AA-CubeSat-Team/soci_pcb/README.md

# soci_pcb

## design_rules
Directory for the design rules of various PCB manufacturers.

## libraries
Directory for Eagle part/component libraries used across PCB designs.

## projects
Repository for PCBs designed for soci in EAGLE

Make sure to update your libraries, design rules, and projects paths by going to Options -> Directories in EAGLE.
