AA-CubeSat-Team/soci_pcb/design_rules/README.md

# Design Rules
Directory for design rules to comply with standards and/or manufacturing requirements for various PCB manufacturers
