AA-CubeSat-Team/soci_pcb/projects/README.md

# CIA_board
Direcotry for CIA board EAGLE files.

# COM_R_board
Direcotry for COM_R board EAGLE files.

# eps_flatsat_module
Directory for the EPS module EAGLE files being designed for use in flatsat testing.

# onboard_flight_computer
Directory for the onboard flight computer EAGLE files.

# real_time_clock_testboard
Directory for the test board for the RTC circuit. The RTC was tested on a breadboard, and this board was never fabricated.

# sensor_board
Directory for the EAGLE files for the sensors board.
