AA-CubeSat-Team/soci_pcb/design_rules/macrofab/README.md

# Design Rules
Directory for design rules to comply with standards and/or manufacturing requirements of MacroFab PCB manufacturing
