AA-CubeSat-Team/soci_pcb/projects/COM_R/README.md

Folder containing PCB files for COM_R board
