AA-CubeSat-Team/soci_pcb/projects/CIA_board/README

Folder containing EAGLE files for the CIA board
