AA-CubeSat-Team/soci_pcb/projects/onboard_flight_computer/old_versions/README.md

# Backup Files
Folder containing backup EAGLE files for the OBC board
