AA-CubeSat-Team/soci_pcb/projects/CIA_board/old_versions/README.md

# Backup Files
Folder containing backup EAGLE files for the CIA board
