AA-CubeSat-Team/soci_pcb/projects/manufactured_brds/README.md

## This folder Contains all of the Eagle files for boards that have been previously manufactured
