AA-CubeSat-Team/soci_pcb/projects/manufactured_brds/CIA_manufactured.brd

## EAGLE design projects/manufactured_brds/CIA_manufactured.brd (2021-11-19)

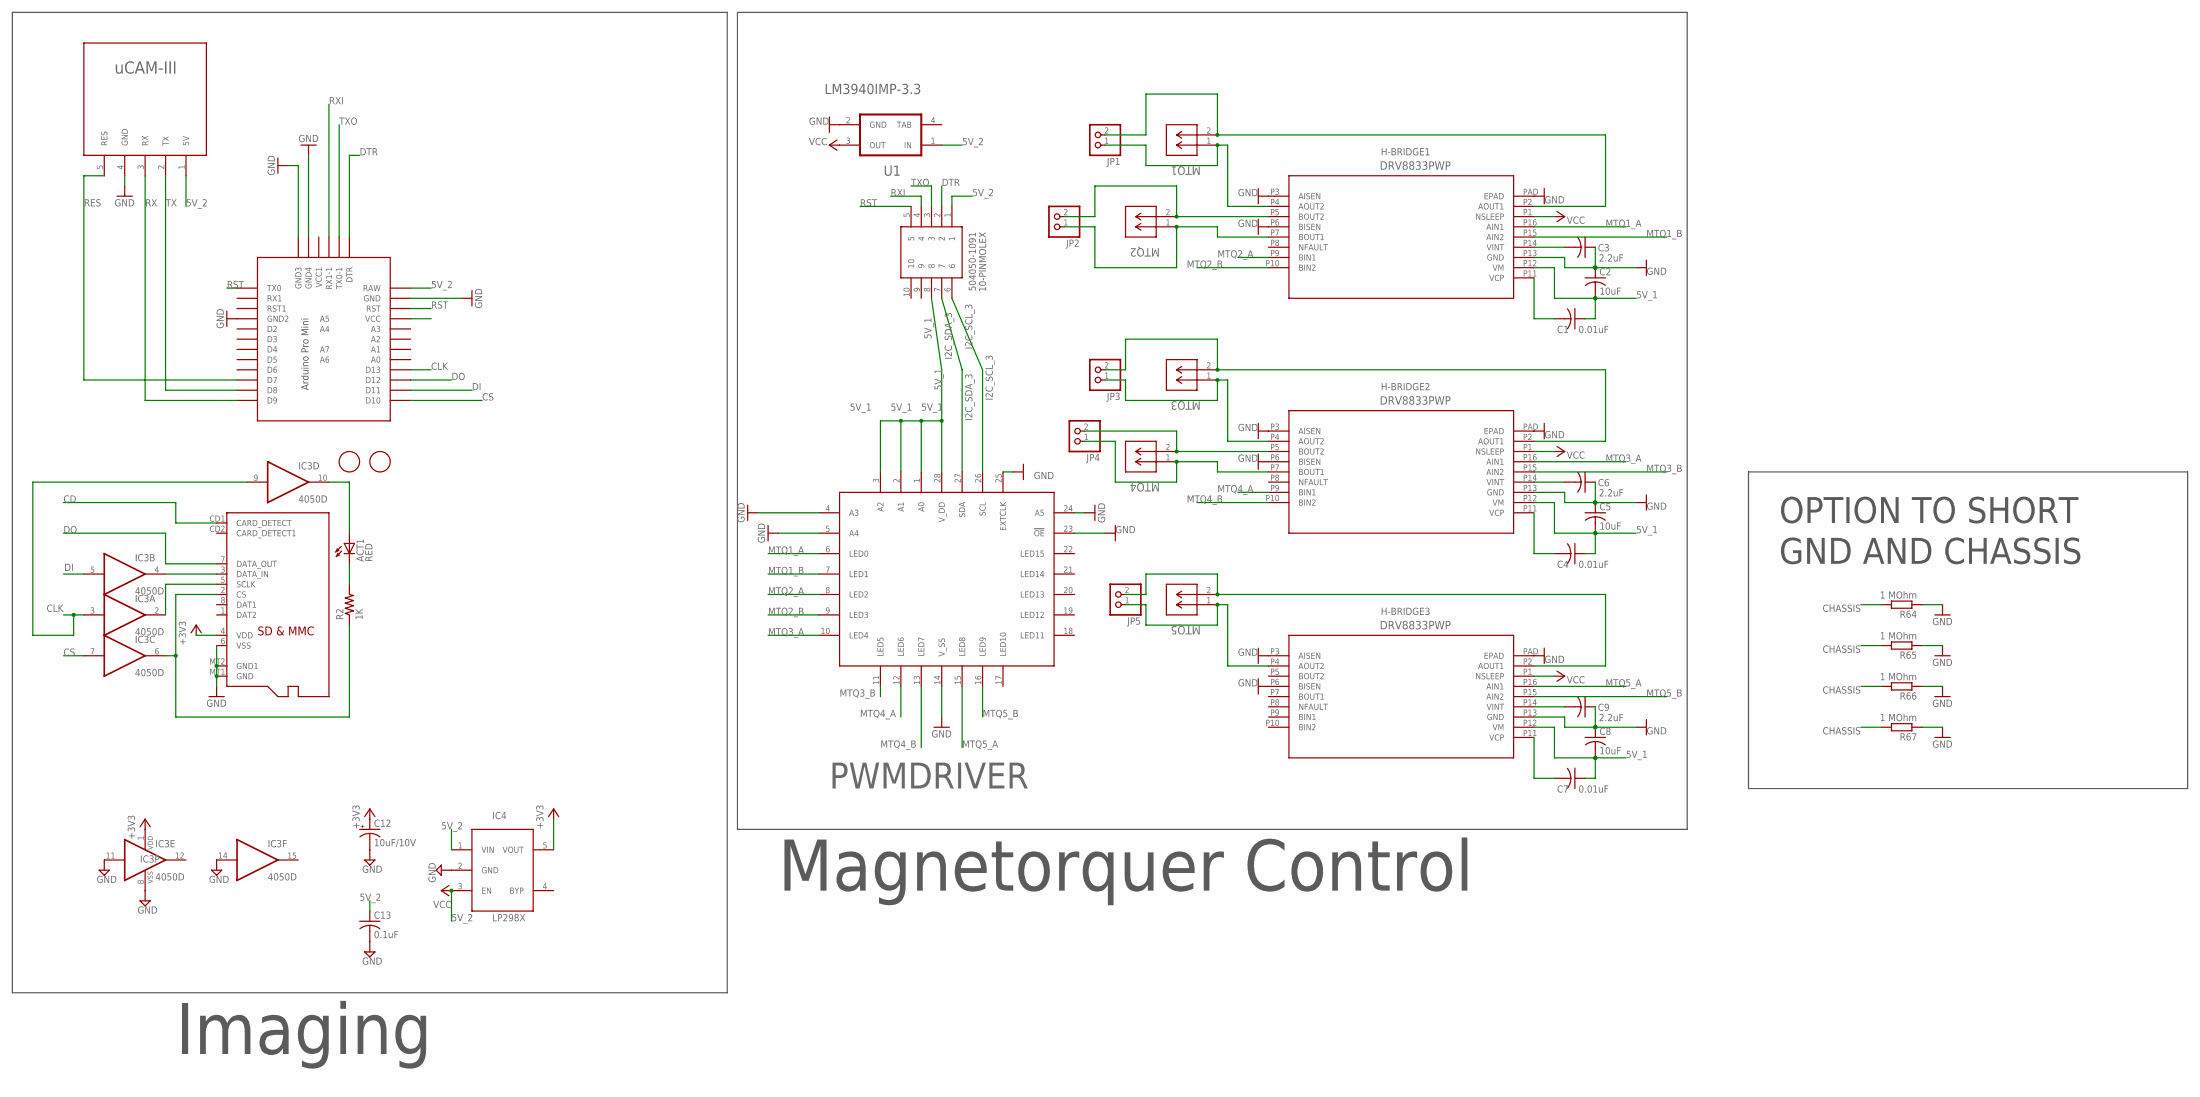
[picture p1: schematic CIA_manufactured.sch]

Parts:
10-PINMOLEX: 504050-1091
ACT1: RED; CHIP-LED0805
C1, C4, C7: 0.01uF; C0603K
C2, C5, C8: 10uF; C1210K
C3, C6, C9: 2.2uF; C0603K
C12: 10uF/10V; A/3216-18R
C13: 0.1uF; C0805K
H-BRIDGE1, H-BRIDGE2, H-BRIDGE3: DRV8833PWP; HTSSOP16
IC3: 4050D; SO16
IC4: LP298XS; SOT23-5L
JP1, JP2, JP3, JP4, JP5: PINHD-1X2; 1X02; MPN 22-11-2022
MTQ1, MTQ2, MTQ3, MTQ4, MTQ5: DF13C-2P-1.25V(51); CON2_1X2_U_DF13
PWMDRIVER: PCA9685PW; TSSOP28
R2: 1K; R0805
R64, R65, R66, R67: 1 MOhm; R0805
U1: TI_NATIONAL_SEMICONDUCTOR_LM3940IMP-3.3TI_NATIONA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; TI_NATIONAL_SEMICONDUCTOR_LM3940IMP-3.3_1
U$2: UCAM-III
U$6, U$7: FIDUCIAL; FIDUCIAL_1MM
U$8: PRO-MINI-2
X2: MICROSD

Connections:
5V_1: 10-PINMOLEX.8, C1.1, C2.2, C4.1, C5.2, C7.1, C8.2, H-BRIDGE1.P12 (VM), H-BRIDGE2.P12 (VM), H-BRIDGE3.P12 (VM), PWMDRIVER.1 (A0), PWMDRIVER.2 (A1), PWMDRIVER.3 (A2), PWMDRIVER.28 (V_DD)
5V_2: 10-PINMOLEX.1, C13.1, IC4.1 (VIN), IC4.3 (EN), U1.1 (IN), U$2.1 (5V), U$8.RAW
+3V3: C12.+, IC3.1 (VDD), IC4.5 (VOUT), X2.4 (VDD)
CD: X2.CD1 (CARD_DETECT)
CHASSIS: R64.2, R65.2, R66.2, R67.2
CLK: IC3.3 (I), IC3.9 (I), U$8.D13
CS: IC3.7 (I), U$8.D10
DI: IC3.5 (I), U$8.D11
DO: U$8.D12, X2.7 (DATA_OUT)
DTR: 10-PINMOLEX.2, U$8.DTR
GND: C2.1, C3.1, C5.1, C6.1, C8.1, C9.1, C12.-, C13.2, H-BRIDGE1.P3 (AISEN), H-BRIDGE1.P6 (BISEN), H-BRIDGE1.P13 (GND), H-BRIDGE1.PAD (EPAD), H-BRIDGE2.P3 (AISEN), H-BRIDGE2.P6 (BISEN), H-BRIDGE2.P13 (GND), H-BRIDGE2.PAD (EPAD), H-BRIDGE3.P3 (AISEN), H-BRIDGE3.P6 (BISEN), H-BRIDGE3.P13 (GND), H-BRIDGE3.PAD (EPAD), IC3.8 (VSS), IC3.11 (I), IC3.14 (I), IC4.2 (GND), PWMDRIVER.4 (A3), PWMDRIVER.5 (A4), PWMDRIVER.14 (V_SS), PWMDRIVER.23 (!OE), PWMDRIVER.24 (A5), PWMDRIVER.25 (EXTCLK), R64.1, R65.1, R66.1, R67.1, U1.2 (GND), U$8.GND, U$8.GND1 (GND2), U$8.GND2 (GND3), U$8.GND3 (GND4), X2.6 (VSS), X2.MT1 (GND), X2.MT2 (GND1)
I2C_SCL_3: 10-PINMOLEX.6, PWMDRIVER.26 (SCL)
I2C_SDA_3: 10-PINMOLEX.7, PWMDRIVER.27 (SDA)
MTQ1_A: H-BRIDGE1.P16 (AIN1), PWMDRIVER.6 (LED0)
MTQ1_B: H-BRIDGE1.P15 (AIN2), PWMDRIVER.7 (LED1)
MTQ2_A: H-BRIDGE1.P9 (BIN1), PWMDRIVER.8 (LED2)
MTQ2_B: H-BRIDGE1.P10 (BIN2), PWMDRIVER.9 (LED3)
MTQ3_A: H-BRIDGE2.P16 (AIN1), PWMDRIVER.10 (LED4)
MTQ3_B: H-BRIDGE2.P15 (AIN2), PWMDRIVER.11 (LED5)
MTQ4_A: H-BRIDGE2.P9 (BIN1), PWMDRIVER.12 (LED6)
MTQ4_B: H-BRIDGE2.P10 (BIN2), PWMDRIVER.13 (LED7)
MTQ5_A: H-BRIDGE3.P16 (AIN1), PWMDRIVER.15 (LED8)
MTQ5_B: H-BRIDGE3.P15 (AIN2), PWMDRIVER.16 (LED9)
unnamed: H-BRIDGE2.P2 (AOUT1), JP3.2, MTQ3.2
unnamed: C3.2, H-BRIDGE1.P14 (VINT)
unnamed: H-BRIDGE1.P4 (AOUT2), JP1.1, MTQ1.1
unnamed: H-BRIDGE1.P2 (AOUT1), JP1.2, MTQ1.2
unnamed: H-BRIDGE1.P7 (BOUT1), JP2.1, MTQ2.1
unnamed: H-BRIDGE1.P5 (BOUT2), JP2.2, MTQ2.2
unnamed: C1.2, H-BRIDGE1.P11 (VCP)
unnamed: H-BRIDGE2.P7 (BOUT1), JP4.1, MTQ4.1
unnamed: H-BRIDGE2.P5 (BOUT2), JP4.2, MTQ4.2
unnamed: C6.2, H-BRIDGE2.P14 (VINT)
unnamed: C4.2, H-BRIDGE2.P11 (VCP)
unnamed: H-BRIDGE2.P4 (AOUT2), JP3.1, MTQ3.1
unnamed: H-BRIDGE3.P2 (AOUT1), JP5.2, MTQ5.2
unnamed: C9.2, H-BRIDGE3.P14 (VINT)
unnamed: C7.2, H-BRIDGE3.P11 (VCP)
unnamed: H-BRIDGE3.P4 (AOUT2), JP5.1, MTQ5.1
unnamed: ACT1.A, IC3.10 (O)
unnamed: IC3.2 (O), X2.5 (SCLK)
unnamed: IC3.6 (O), R2.1, X2.2 (CS)
unnamed: ACT1.C, R2.2
unnamed: IC3.4 (O), X2.3 (DATA_IN)
RES: U$2.5 (RES), U$8.D7
RST: 10-PINMOLEX.5, U$8.RST
RX: U$2.3 (RX), U$8.D9
RXI: 10-PINMOLEX.4, U$8.RX1-1
TAB: U1.4 (TAB)
TX: U$2.2 (TX), U$8.D8
TXO: 10-PINMOLEX.3, U$8.TX0-1
VCC: H-BRIDGE1.P1 (NSLEEP), H-BRIDGE2.P1 (NSLEEP), H-BRIDGE3.P1 (NSLEEP), U1.3 (OUT)

Notes on the sheet:
Imaging
Magnetorquer Control
OPTION TO SHORT
GND AND CHASSIS

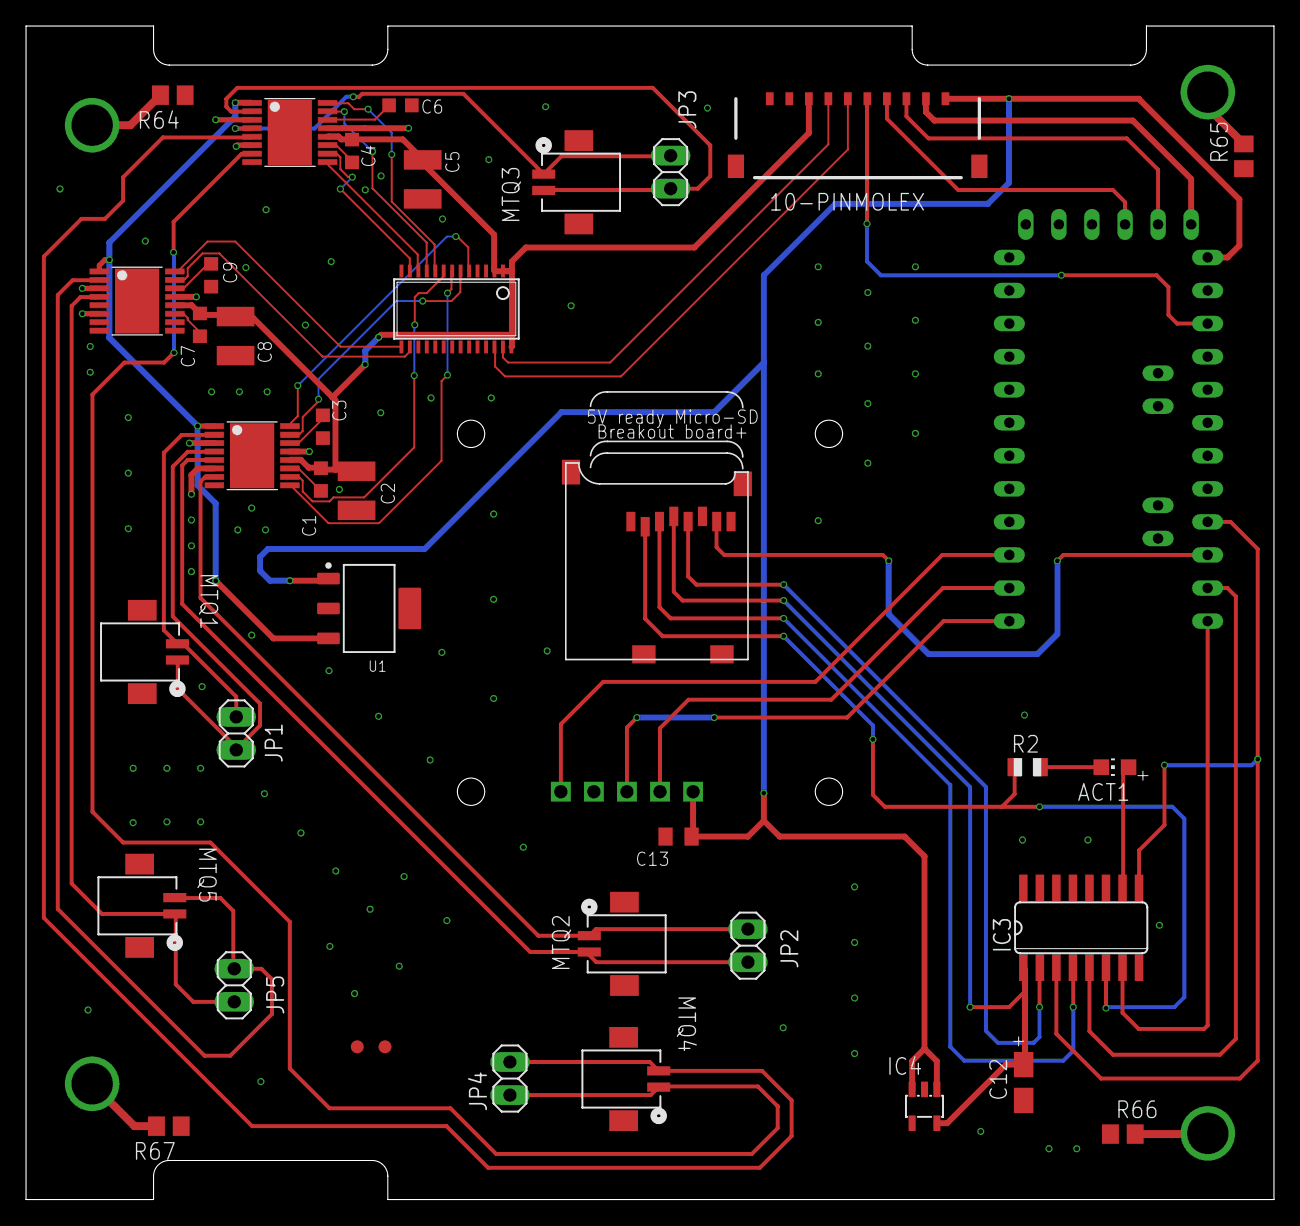
[picture p2: board CIA_manufactured.brd from above]

Board: 4 copper layers, 95.9 x 90.2 mm, 40 parts (0 on the bottom side), 50 nets.
