AA-CubeSat-Team/soci_pcb/projects/manufactured_brds/COM_R_manufactured.brd

## EAGLE design projects/manufactured_brds/COM_R_manufactured.brd (2021-11-19)

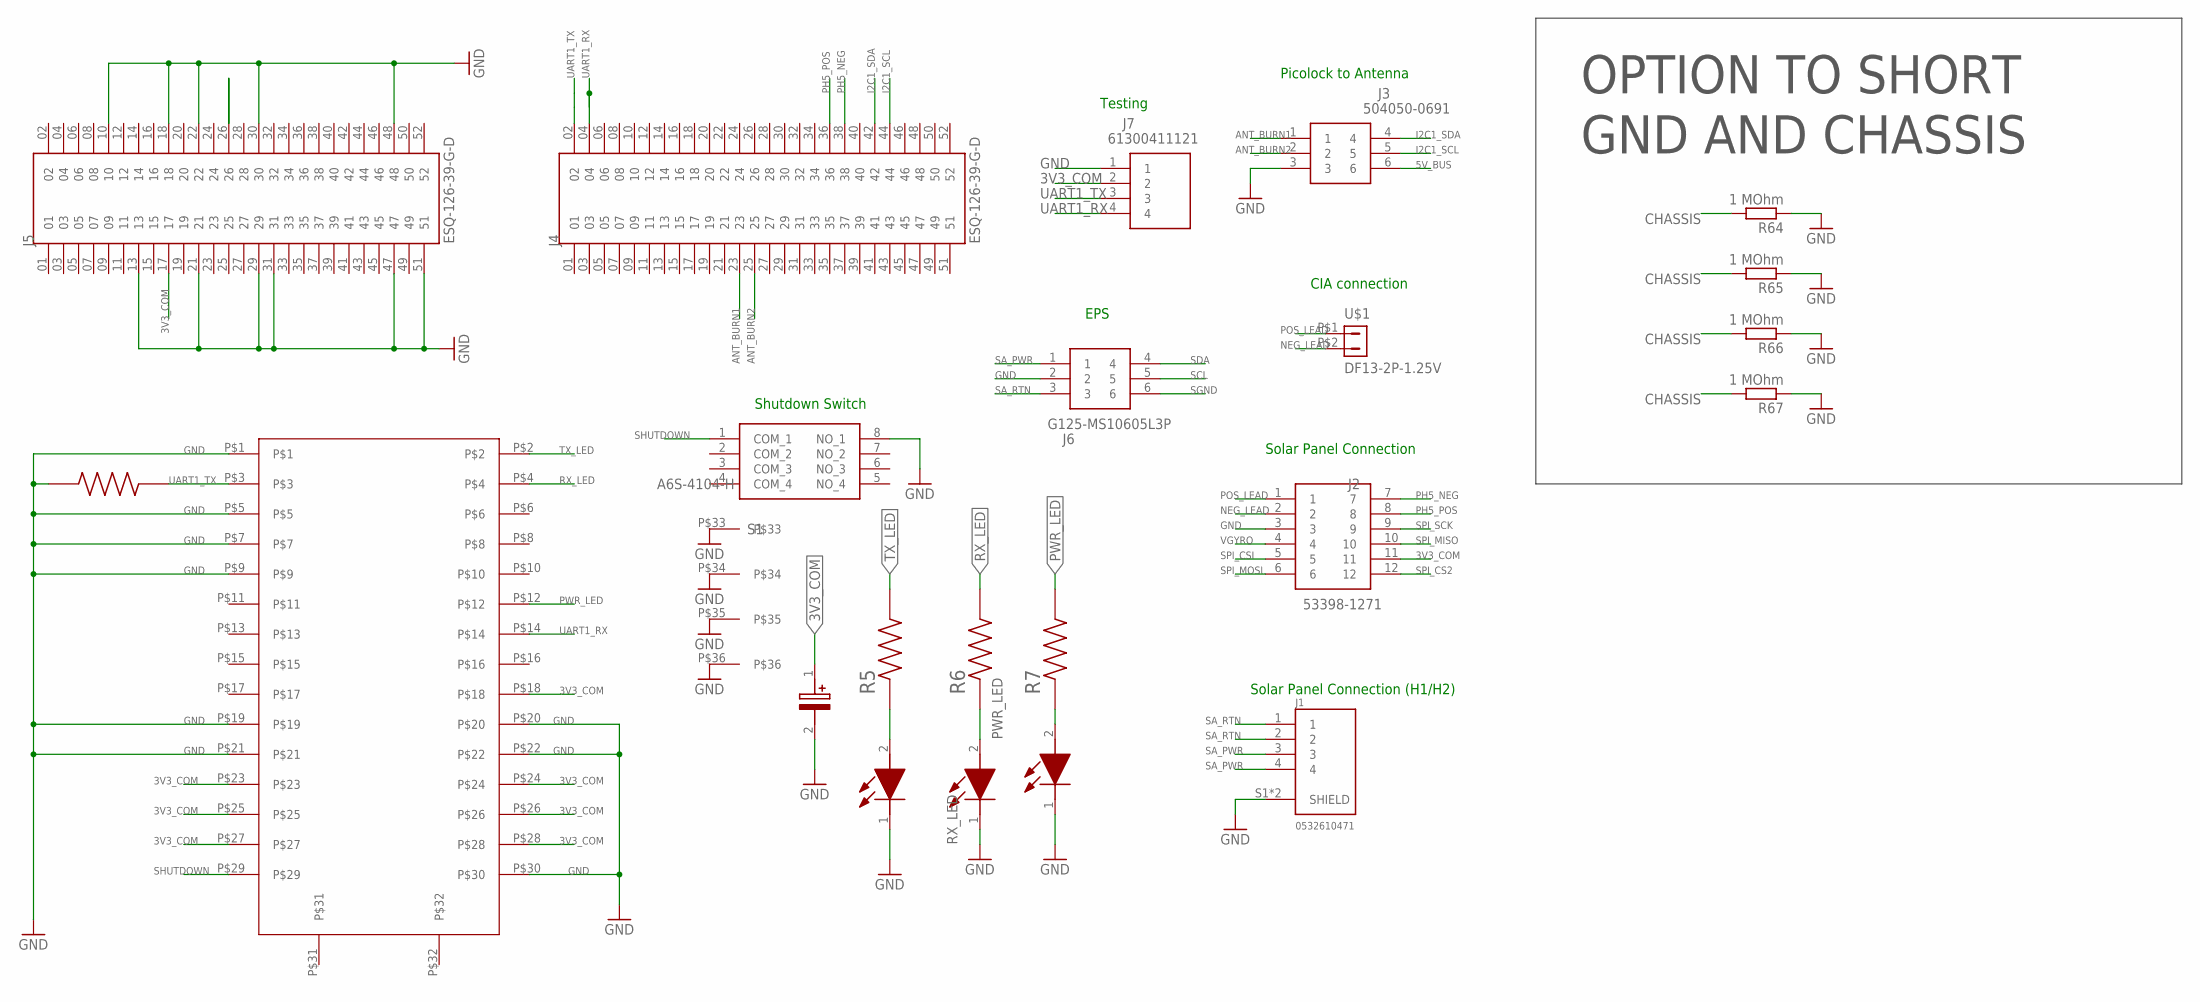
[picture p3: schematic COM_R_manufactured.sch]

Parts:
C2: 293D106X0010A2TE3; CAPPM3216X180N
J1: 0532610471; MOLEX_0532610471
J2: 53398-1271
J3: 504050-0691; 504050-0691_2
J4, J5: ESQ-126-39-G-D; SAMTEC_ESQ-126-39-G-D
J6: G125-MS10605L3P
J7: 61300411121; HDRV4W95P0X254_1X4_1016X254X85
PWR_LED: HSMQ-C170-T0000; LEDC2012X90N
R3: TNPW080510K0BETY; RESC2012X55N
R5, R6, R7: Y40621K00000Q0R; RESC2012X64N
R64, R65, R66, R67: 1 MOhm; R0805
RX_LED: HSMQ-C170-T0000; LEDC2012X90N
S1: A6S-4104-H; A6S4104H
TX_LED: HSMQ-C170-T0000; LEDC2012X90N
U$1: DF13-2P-1.25V; DF13C-2P-1.25V
U$3: XDLRADIOCONNECTORBREAKOUT_KYOCERA_5046_30PIN

Connections:
3V3_COM: C2.1 (+), J2.11, J5.17, J7.2, U$3.P$18, U$3.P$23, U$3.P$24, U$3.P$25, U$3.P$26, U$3.P$27, U$3.P$28
5V_BUS: J3.6, J5.26
ANT_BURN1: J3.1, J4.23
ANT_BURN2: J3.2, J4.25
CHASSIS: R64.2, R65.2, R66.2, R67.2
GND: C2.2 (-), J1.S1 (SHIELD), J1.S2 (SHIELD), J2.3, J3.3, J5.10, J5.13, J5.18, J5.21, J5.22, J5.29, J5.30, J5.31, J5.47, J5.48, J5.51, J6.2, J7.1, PWR_LED.1 (K), R3.1, R64.1, R65.1, R66.1, R67.1, RX_LED.1 (K), S1.8 (NO_1), TX_LED.1 (K), U$3.P$1, U$3.P$5, U$3.P$7, U$3.P$9, U$3.P$19, U$3.P$20, U$3.P$21, U$3.P$22, U$3.P$30, U$3.P$33, U$3.P$34, U$3.P$35, U$3.P$36
I2C1_SCL: J3.5, J4.44
I2C1_SDA: J3.4, J4.42
unnamed: R5.1, TX_LED.2 (A)
unnamed: PWR_LED.2 (A), R7.1
unnamed: R6.1, RX_LED.2 (A)
NEG_LEAD: J2.2, U$1.P$2 (2)
PH5_NEG: J2.7, J4.38
PH5_POS: J2.8, J4.36
POS_LEAD: J2.1, U$1.P$1 (1)
PWR_LED: R7.2, U$3.P$12
RX_LED: R6.2, U$3.P$4
SA_PWR: J1.3, J1.4, J6.1
SA_RTN: J1.1, J1.2, J6.3
SCL: J6.5
SDA: J6.4
SGND: J6.6
SHUTDOWN: S1.1 (COM_1), U$3.P$29
SPI_CS2: J2.12
SPI_CSI: J2.5
SPI_MISO: J2.10
SPI_MOSI: J2.6
SPI_SCK: J2.9
TX_LED: R5.2, U$3.P$2
UART1_RX: J4.04, J7.4, U$3.P$14
UART1_TX: J4.02, J7.3, R3.2, U$3.P$3
VGYRO: J2.4

Notes on the sheet:
Solar Panel Connection
Picolock to Antenna
Solar Panel Connection (H1/H2)
Shutdown Switch
CIA connection
EPS
Testing
OPTION TO SHORT
GND AND CHASSIS

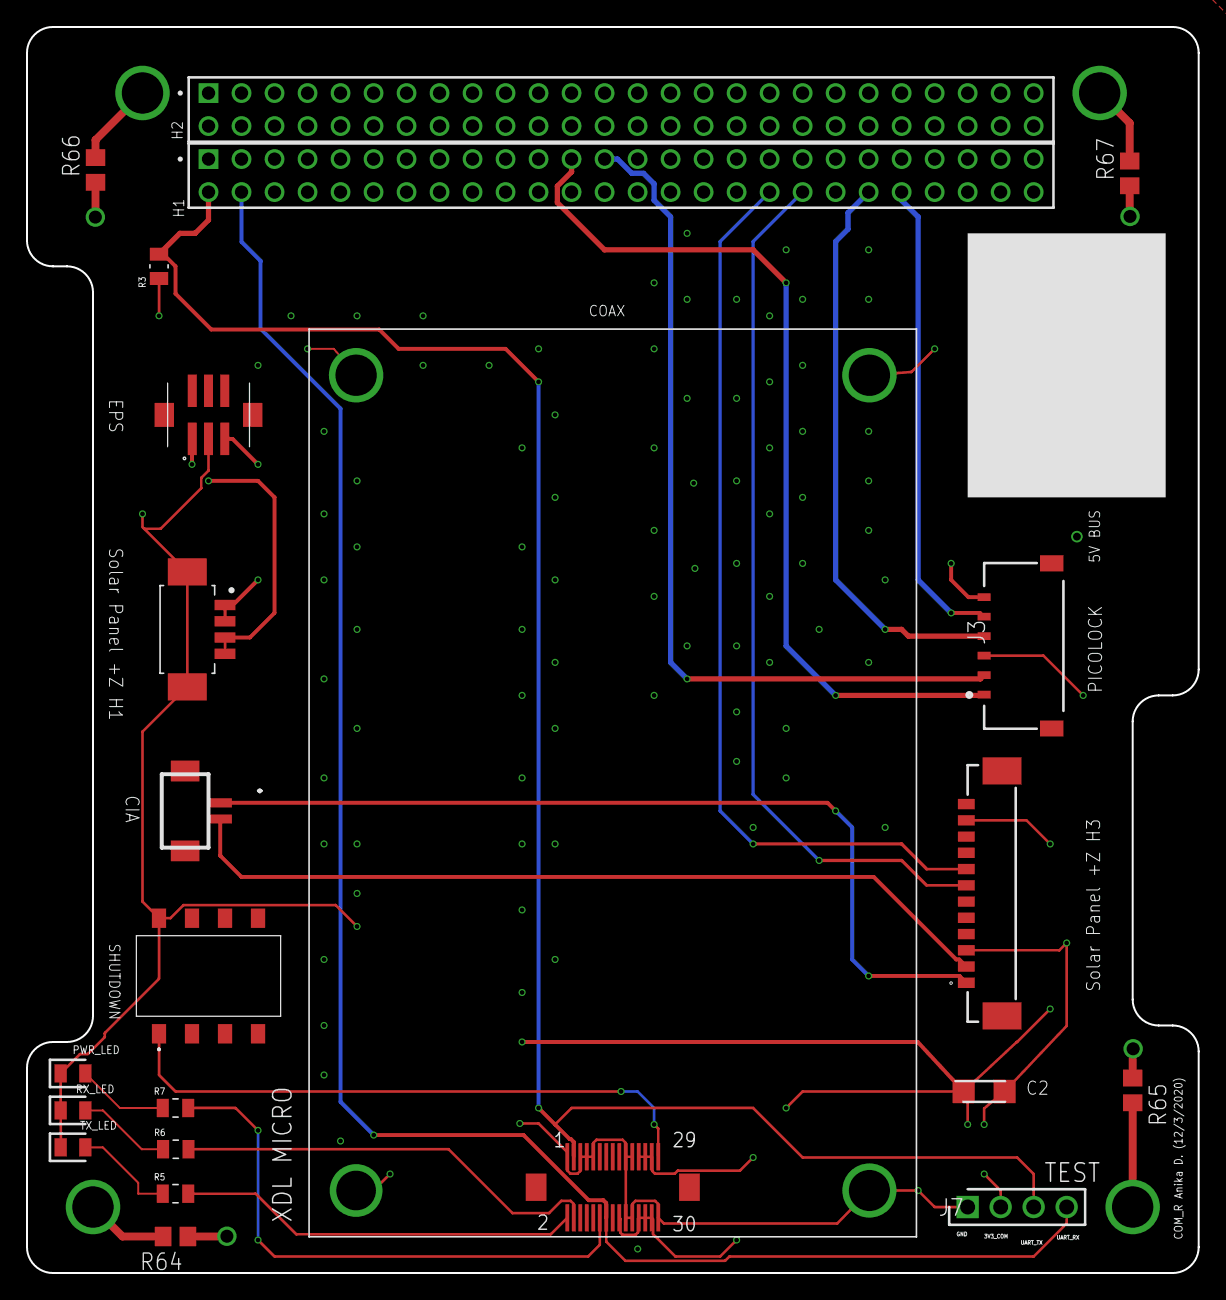
[picture p4: board COM_R_manufactured.brd from above]

Board: 4 copper layers, 90.2 x 95.9 mm, 22 parts (0 on the bottom side), 23 nets.
