AA-CubeSat-Team/soci_pcb/projects/manufactured_brds/OBC_manufactured.brd

## EAGLE design projects/manufactured_brds/OBC_manufactured.brd (2021-10-27)

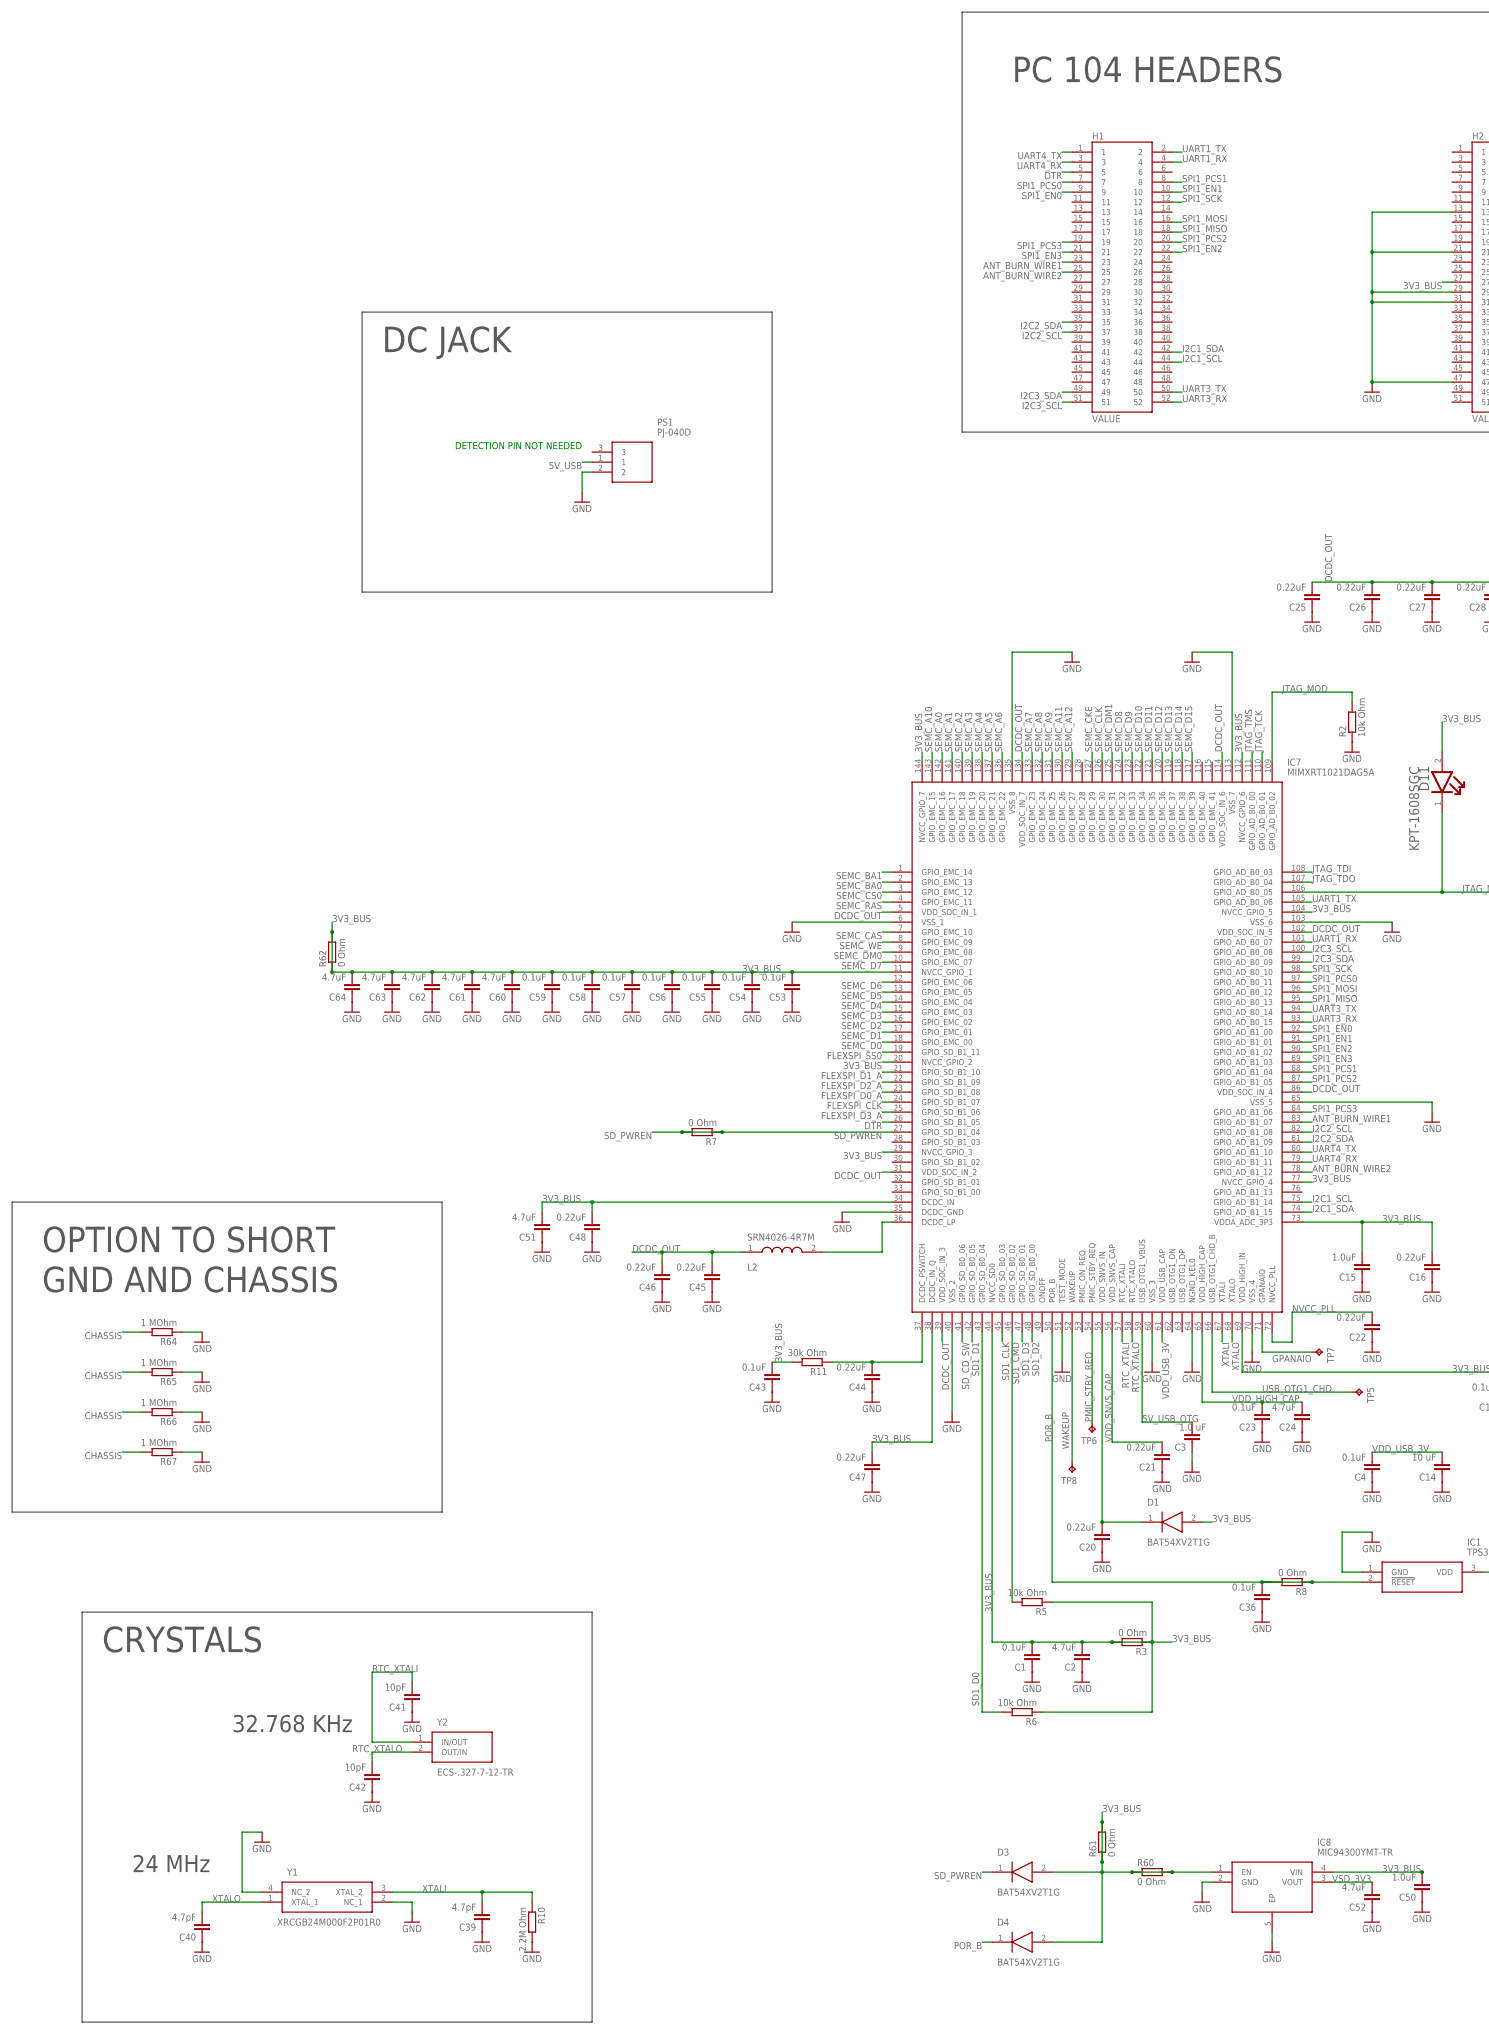
[picture p5: schematic OBC_manufactured.sch, MCU, part in row 1, column 1]

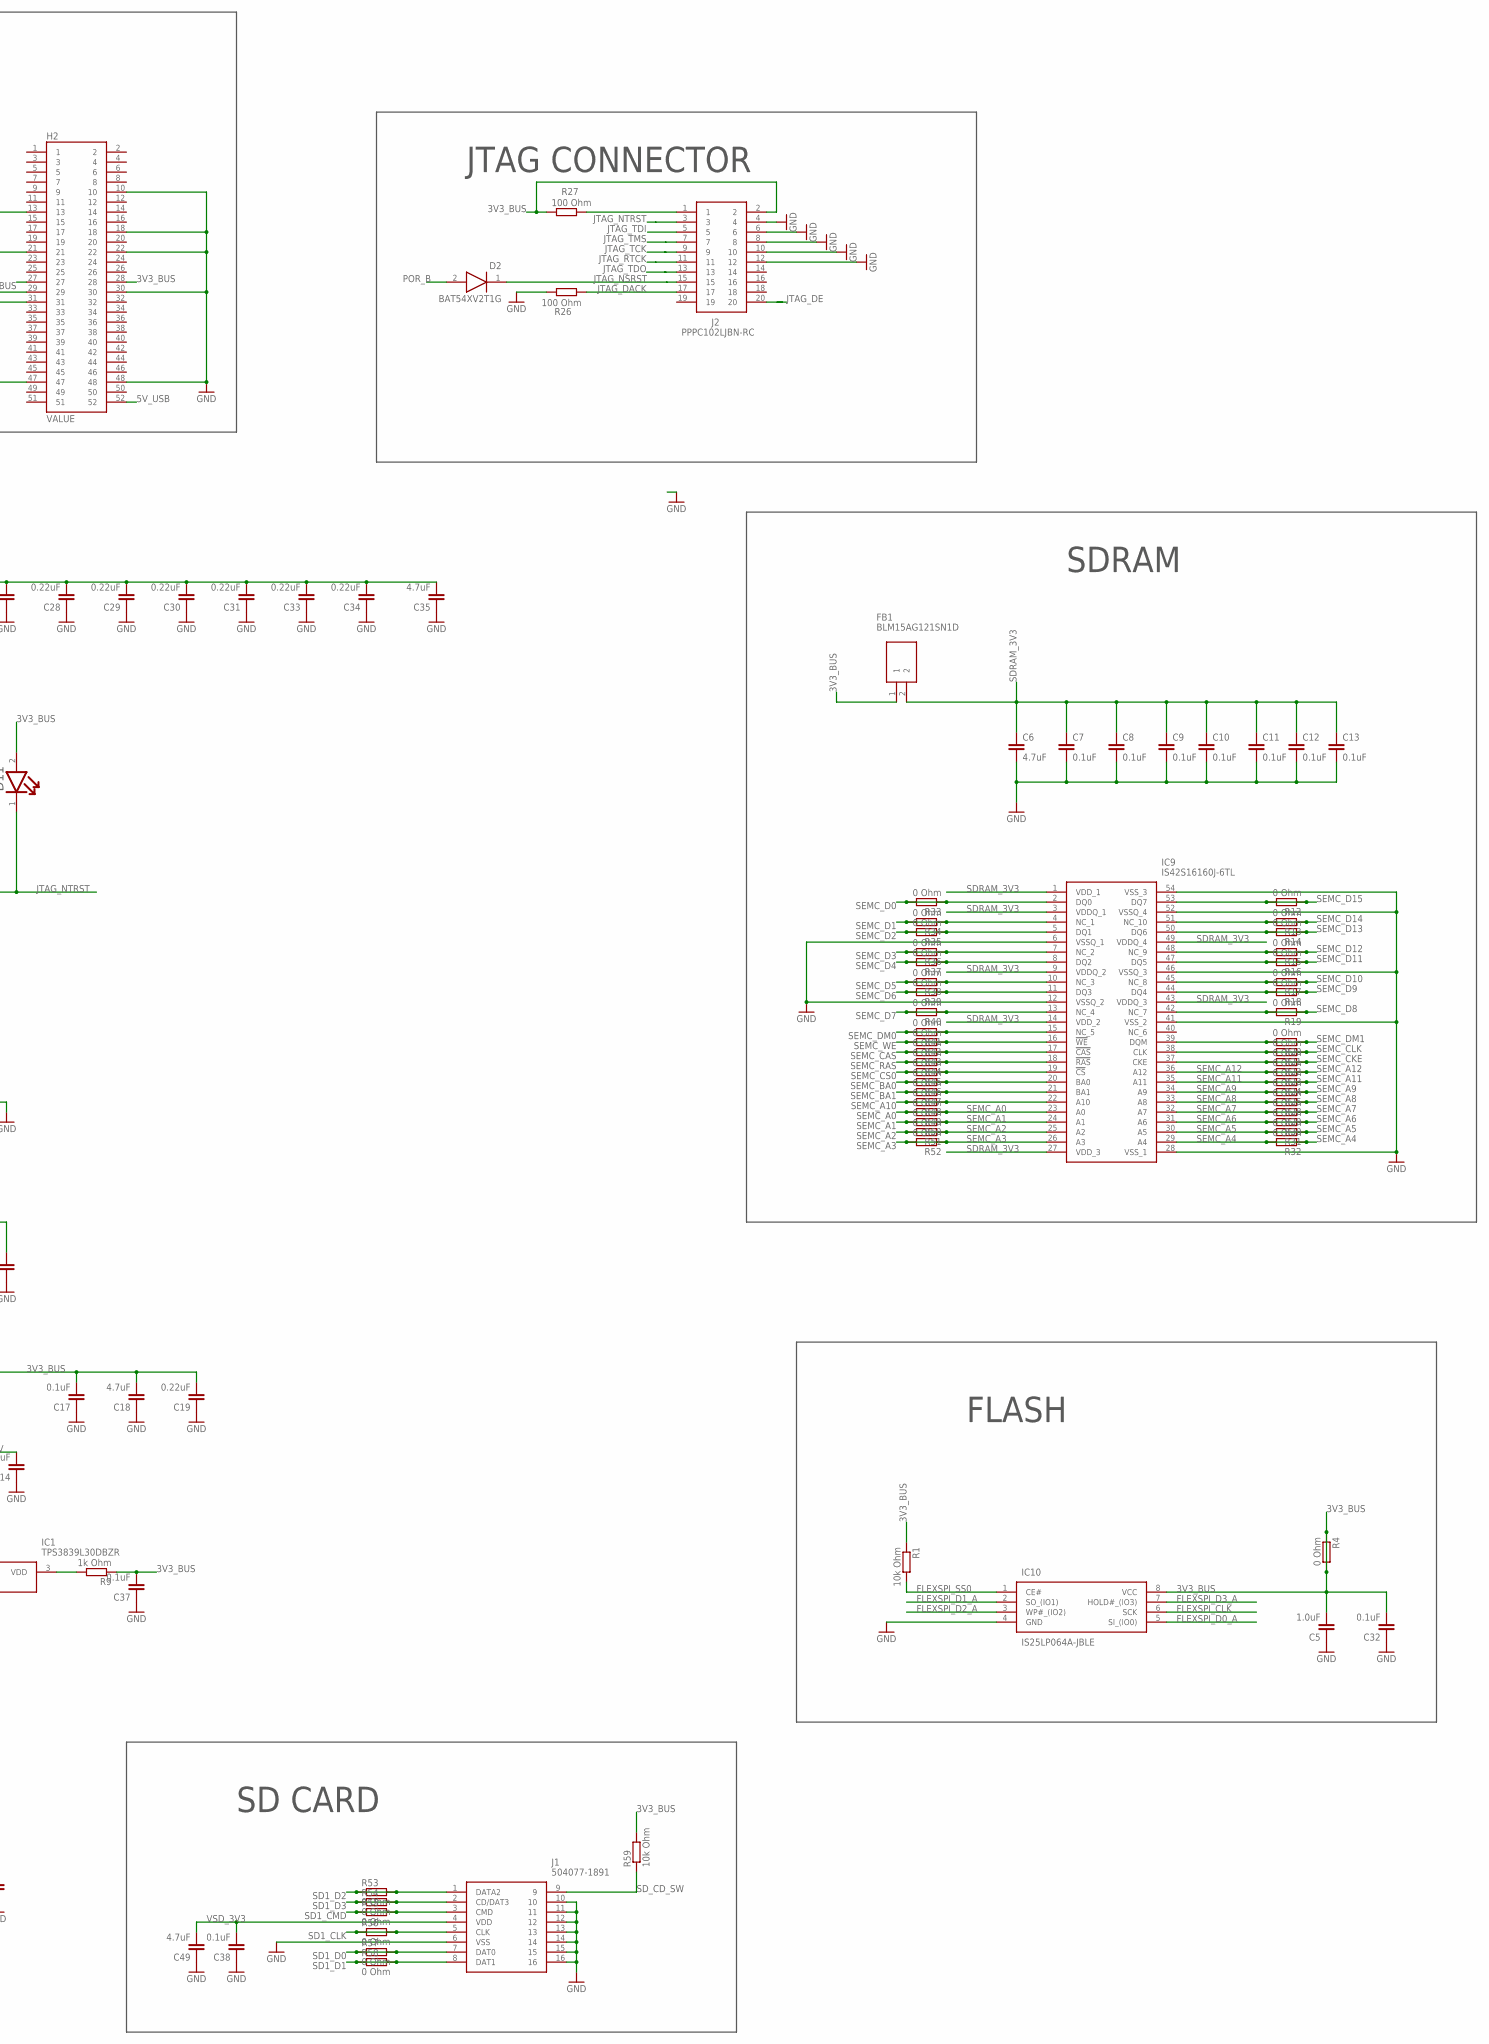
[picture p6: schematic OBC_manufactured.sch, MCU, part in row 1, column 2]

Parts:
C1, C4, C7, C8, C9, C10, C11, C12, C13, C17, C23, C32, C36, C37, C38, C43, C53, C54, C55, C56, C57, C58, C59: 0.1uF; C0402K
C2, C6, C18, C24, C35, C49, C51, C52, C60, C61, C62, C63, C64: 4.7uF; C0402K
C3: 1.0 uF; C0402K
C5, C15, C50: 1.0uF; C0402K
C14: 10 uF; C0402K
C16, C19, C20, C21, C22, C25, C26, C27, C28, C29, C30, C31, C33, C34, C44, C45, C46, C47, C48: 0.22uF; C0402K
C39, C40: 4.7pF; C0402K
C41, C42: 10pF; C0402K
D1, D2, D3, D4: BAT54XV2T1G; SODFL1608X70N
D11: KINGBRIGHT_KPT-1608SGCKINGBRIGHT_KPT-1608SGC_0_0; KINGBRIGHT_KPT-1608SGC_0
FB1: BLM15AG121SN1D; NFZ15SG152SN10B
H1, H2: ESQ-126-39-G-D; SAMTEC_ESQ-126-39-G-D
IC1: TPS3839L30DBZR; SOT95P237X112-3N
IC7: MIMXRT1021DAG5A; QFP50P2200X2200X160-144N
IC8: MIC94300YMT-TR; SON50P160X120X60-5N
IC9: IS42S16160J-6TL; SOP80P1176X120-54N
IC10: IS25LP064A-JBLE; SOIC127P790X216-8N
J1: 504077-1891; 5040771891
J2: PPPC102LJBN-RC; RHDRRA20W60P254X254_2X10_2590X
L2: SRN4026-4R7M; SRN4026
PS1: PJ-040D; PJ040D
R1, R2, R5, R6, R59: 10k Ohm; R0402
R3, R4, R7, R8, R12, R13, R14, R15, R16, R17, R18, R19, R20, R21, R22, R23, R24, R25, R28, R29, R30, R31, R32, R33, R34, R35, R36, R37, R38, R39, R40, R41, R42, R43, R44, R45, R46, R47, R48, R49, R50, R51, R52, R53, R54, R55, R56, R57, R58, R60, R61, R62: 0 Ohm; R0402
R9: 1k Ohm; R0402
R10: 2.2M Ohm; R0402
R11: 30k Ohm; R0402
R26, R27: 100 Ohm; R0402
R64, R65, R66, R67: 1 MOhm; R0805
TP5, TP6, TP7, TP8: TPTP06R; TP06R
Y1: XRCGB24M000F2P01R0
Y2: ECS-.327-7-12-TR; ECS327712TR

Connections:
3V3_BUS: C1.2, C2.2, C5.2, C15.2, C16.2, C17.2, C18.2, C19.2, C32.2, C37.2, C43.2, C47.2, C48.2, C50.2, C51.2, C53.2, C54.2, C55.2, C56.2, C57.2, C58.2, C59.2, C60.2, C61.2, C62.2, C63.2, C64.2, D1.2 (A), D3.2 (A), D4.2 (A), D11.2 (ANODE), FB1.1, H2.27, H2.28, IC7.11 (NVCC_GPIO_1), IC7.20 (NVCC_GPIO_2), IC7.29 (NVCC_GPIO_3), IC7.34 (DCDC_IN), IC7.38 (DCDC_IN_Q), IC7.44 (NVCC_SD0), IC7.69 (VDD_HIGH_IN), IC7.73 (VDDA_ADC_3P3), IC7.77 (NVCC_GPIO_4), IC7.104 (NVCC_GPIO_5), IC7.112 (NVCC_GPIO_6), IC7.144 (NVCC_GPIO_7), IC8.1 (EN), IC8.4 (VIN), IC10.8 (VCC), J2.2, R1.1, R3.1, R3.2, R4.1, R4.2, R5.1, R6.1, R9.1, R11.2, R27.1, R59.2, R60.1, R60.2, R61.1, R61.2, R62.1, R62.2
5V_USB: H2.52, PS1.1
5V_USB_OTG: C3.2, IC7.59 (USB_OTG1_VBUS)
ANT_BURN_WIRE1: H1.23, IC7.83 (GPIO_AD_B1_07)
ANT_BURN_WIRE2: H1.25, IC7.78 (GPIO_AD_B1_12)
CHASSIS: R64.2, R65.2, R66.2, R67.2
DCDC_OUT: C25.2, C26.2, C27.2, C28.2, C29.2, C30.2, C31.2, C33.2, C34.2, C35.2, C45.2, C46.2, IC7.5 (VDD_SOC_IN_1), IC7.31 (VDD_SOC_IN_2), IC7.39 (VDD_SOC_IN_3), IC7.86 (VDD_SOC_IN_4), IC7.102 (VDD_SOC_IN_5), IC7.114 (VDD_SOC_IN_6), IC7.134 (VDD_SOC_IN_7), L2.1
DTR: H1.5, IC7.26 (GPIO_SD_B1_05)
FLEXSPI_CLK: IC7.24 (GPIO_SD_B1_07), IC10.6 (SCK)
FLEXSPI_D0_A: IC7.23 (GPIO_SD_B1_08), IC10.5 (SI_(IO0))
FLEXSPI_D1_A: IC7.21 (GPIO_SD_B1_10), IC10.2 (SO_(IO1))
FLEXSPI_D2_A: IC7.22 (GPIO_SD_B1_09), IC10.3 (WP#_(IO2))
FLEXSPI_D3_A: IC7.25 (GPIO_SD_B1_06), IC10.7 (HOLD#_(IO3))
FLEXSPI_SS0: IC7.19 (GPIO_SD_B1_11), IC10.1 (CE#), R1.2
GND: C1.1, C2.1, C3.1, C4.1, C5.1, C6.2, C7.2, C8.2, C9.2, C10.2, C11.2, C12.2, C13.2, C14.1, C15.1, C16.1, C17.1, C18.1, C19.1, C20.1, C21.1, C22.1, C23.1, C24.1, C25.1, C26.1, C27.1, C28.1, C29.1, C30.1, C31.1, C32.1, C33.1, C34.1, C35.1, C36.1, C37.1, C38.1, C39.1, C40.1, C41.1, C42.1, C43.1, C44.1, C45.1, C46.1, C47.1, C48.1, C49.1, C50.1, C51.1, C52.1, C53.1, C54.1, C55.1, C56.1, C57.1, C58.1, C59.1, C60.1, C61.1, C62.1, C63.1, C64.1, H2.10, H2.13, H2.18, H2.21, H2.22, H2.29, H2.30, H2.31, H2.47, H2.48, IC1.1 (GND), IC7.6 (VSS_1), IC7.35 (DCDC_GND), IC7.40 (VSS_2), IC7.51 (TEST_MODE), IC7.60 (VSS_3), IC7.64 (NGND_KEL0), IC7.70 (VSS_4), IC7.85 (VSS_5), IC7.103 (VSS_6), IC7.113 (VSS_7), IC7.135 (VSS_8), IC8.2 (GND), IC8.5 (EP), IC9.6 (VSSQ_1), IC9.12 (VSSQ_2), IC9.28 (VSS_1), IC9.41 (VSS_2), IC9.46 (VSSQ_3), IC9.52 (VSSQ_4), IC9.54 (VSS_3), IC10.4 (GND), J1.6 (VSS), J1.10, J1.11, J1.12, J1.13, J1.14, J1.15, J1.16, J2.4, J2.6, J2.8, J2.10, J2.12, PS1.2, R2.1, R10.2, R26.2, R64.1, R65.1, R66.1, R67.1, Y1.2 (NC_1), Y1.4 (NC_2)
GPANAIO: IC7.71 (GPANAIO), TP7.TP
I2C1_SCL: H1.44, IC7.75 (GPIO_AD_B1_14)
I2C1_SDA: H1.42, IC7.74 (GPIO_AD_B1_15)
I2C2_SCL: H1.37, IC7.82 (GPIO_AD_B1_08)
I2C2_SDA: H1.35, IC7.81 (GPIO_AD_B1_09)
I2C3_SCL: H1.51, IC7.100 (GPIO_AD_B0_08)
I2C3_SDA: H1.49, IC7.99 (GPIO_AD_B0_09)
JTAG_DACK: J2.17, R26.1
JTAG_DE: J2.20
JTAG_MOD: IC7.109 (GPIO_AD_B0_02), R2.2
JTAG_NSRST: D2.1 (K), J2.15
JTAG_NTRST: D11.1 (CATHODE), IC7.106 (GPIO_AD_B0_05), J2.3
JTAG_RTCK: J2.11
JTAG_TCK: IC7.110 (GPIO_AD_B0_01), J2.9
JTAG_TDI: IC7.108 (GPIO_AD_B0_03), J2.5
JTAG_TDO: IC7.107 (GPIO_AD_B0_04), J2.13
JTAG_TMS: IC7.111 (GPIO_AD_B0_00), J2.7
unnamed: J2.1, R27.2
unnamed: IC1.3 (VDD), R9.2
unnamed: IC7.36 (DCDC_LP), L2.2
unnamed: C44.2, IC7.37 (DCDC_PSWITCH), R11.1
unnamed: C20.2, D1.1 (K), IC7.55 (VDD_SNVS_IN)
NVCC_PLL: C22.2, IC7.72 (NVCC_PLL)
PMIC_STBY_REQ: IC7.54 (PMIC_STBY_REQ), TP6.TP
POR_B: C36.2, D2.2 (A), D4.1 (K), IC1.2 (!RESET), IC7.50 (POR_B), R8.1, R8.2
RTC_XTALI: C41.2, IC7.57 (RTC_XTALI), Y2.1 (IN/OUT)
RTC_XTALO: C42.2, IC7.58 (RTC_XTALO), Y2.2 (OUT/IN)
SD1_CLK: IC7.45 (GPIO_SD_B0_03), J1.5 (CLK), R56.1, R56.2
SD1_CMD: IC7.46 (GPIO_SD_B0_02), J1.3 (CMD), R5.2, R55.1, R55.2
SD1_D0: IC7.43 (GPIO_SD_B0_04), J1.7 (DAT0), R6.2, R57.1, R57.2
SD1_D1: IC7.42 (GPIO_SD_B0_05), J1.8 (DAT1), R58.1, R58.2
SD1_D2: IC7.48 (GPIO_SD_B0_00), J1.1 (DATA2), R53.1, R53.2
SD1_D3: IC7.47 (GPIO_SD_B0_01), J1.2 (CD/DAT3), R54.1, R54.2
SDRAM_3V3: C6.1, C7.1, C8.1, C9.1, C10.1, C11.1, C12.1, C13.1, FB1.2, IC9.1 (VDD_1), IC9.3 (VDDQ_1), IC9.9 (VDDQ_2), IC9.14 (VDD_2), IC9.27 (VDD_3), IC9.43 (VDDQ_3), IC9.49 (VDDQ_4)
SD_CD_SW: IC7.41 (GPIO_SD_B0_06), J1.9, R59.1
SD_PWREN: D3.1 (K), IC7.27 (GPIO_SD_B1_04), R7.1, R7.2
SEMC_A0: IC7.142 (GPIO_EMC_16), IC9.23 (A0), R49.1, R49.2
SEMC_A1: IC7.141 (GPIO_EMC_17), IC9.24 (A1), R50.1, R50.2
SEMC_A2: IC7.140 (GPIO_EMC_18), IC9.25 (A2), R51.1, R51.2
SEMC_A3: IC7.139 (GPIO_EMC_19), IC9.26 (A3), R52.1, R52.2
SEMC_A4: IC7.138 (GPIO_EMC_20), IC9.29 (A4), R32.1, R32.2
SEMC_A5: IC7.137 (GPIO_EMC_21), IC9.30 (A5), R31.1, R31.2
SEMC_A6: IC7.136 (GPIO_EMC_22), IC9.31 (A6), R30.1, R30.2
SEMC_A7: IC7.133 (GPIO_EMC_23), IC9.32 (A7), R29.1, R29.2
SEMC_A8: IC7.132 (GPIO_EMC_24), IC9.33 (A8), R28.1, R28.2
SEMC_A9: IC7.131 (GPIO_EMC_25), IC9.34 (A9), R25.1, R25.2
SEMC_A10: IC7.143 (GPIO_EMC_15), IC9.22 (A10), R48.1, R48.2
SEMC_A11: IC7.130 (GPIO_EMC_26), IC9.35 (A11), R24.1, R24.2
SEMC_A12: IC7.129 (GPIO_EMC_27), IC9.36 (A12), R23.1, R23.2
SEMC_BA0: IC7.2 (GPIO_EMC_13), IC9.20 (BA0), R46.1, R46.2
SEMC_BA1: IC7.1 (GPIO_EMC_14), IC9.21 (BA1), R47.1, R47.2
SEMC_CAS: IC7.7 (GPIO_EMC_10), IC9.17 (!CAS), R43.1, R43.2
SEMC_CKE: IC7.127 (GPIO_EMC_29), IC9.37 (CKE), R22.1, R22.2
SEMC_CLK: IC7.126 (GPIO_EMC_30), IC9.38 (CLK), R21.1, R21.2
SEMC_CS0: IC7.3 (GPIO_EMC_12), IC9.19 (!CS), R45.1, R45.2
SEMC_D0: IC7.18 (GPIO_EMC_00), IC9.2 (DQ0), R33.1, R33.2
SEMC_D1: IC7.17 (GPIO_EMC_01), IC9.4 (NC_1), R34.1, R34.2
SEMC_D2: IC7.16 (GPIO_EMC_02), IC9.5 (DQ1), R35.1, R35.2
SEMC_D3: IC7.15 (GPIO_EMC_03), IC9.7 (NC_2), R36.1, R36.2
SEMC_D4: IC7.14 (GPIO_EMC_04), IC9.8 (DQ2), R37.1, R37.2
SEMC_D5: IC7.13 (GPIO_EMC_05), IC9.10 (NC_3), R38.1, R38.2
SEMC_D6: IC7.12 (GPIO_EMC_06), IC9.11 (DQ3), R39.1, R39.2
SEMC_D7: IC7.10 (GPIO_EMC_07), IC9.13 (NC_4), R40.1, R40.2
SEMC_D8: IC7.124 (GPIO_EMC_32), IC9.42 (NC_7), R19.1, R19.2
SEMC_D9: IC7.123 (GPIO_EMC_33), IC9.44 (DQ4), R18.1, R18.2
SEMC_D10: IC7.122 (GPIO_EMC_34), IC9.45 (NC_8), R17.1, R17.2
SEMC_D11: IC7.121 (GPIO_EMC_35), IC9.47 (DQ5), R16.1, R16.2
SEMC_D12: IC7.120 (GPIO_EMC_36), IC9.48 (NC_9), R15.1, R15.2
SEMC_D13: IC7.119 (GPIO_EMC_37), IC9.50 (DQ6), R14.1, R14.2
SEMC_D14: IC7.118 (GPIO_EMC_38), IC9.51 (NC_10), R13.1, R13.2
SEMC_D15: IC7.117 (GPIO_EMC_39), IC9.53 (DQ7), R12.1, R12.2
SEMC_DM0: IC7.9 (GPIO_EMC_08), IC9.15 (NC_5), R41.1, R41.2
SEMC_DM1: IC7.125 (GPIO_EMC_31), IC9.39 (DQM), R20.1, R20.2
SEMC_RAS: IC7.4 (GPIO_EMC_11), IC9.18 (!RAS), R44.1, R44.2
SEMC_WE: IC7.8 (GPIO_EMC_09), IC9.16 (!WE), R42.1, R42.2
SPI1_EN0: H1.9, IC7.92 (GPIO_AD_B1_00)
SPI1_EN1: H1.10, IC7.91 (GPIO_AD_B1_01)
SPI1_EN2: H1.22, IC7.90 (GPIO_AD_B1_02)
SPI1_EN3: H1.21, IC7.89 (GPIO_AD_B1_03)
SPI1_MISO: H1.18, IC7.95 (GPIO_AD_B0_13)
SPI1_MOSI: H1.16, IC7.96 (GPIO_AD_B0_12)
SPI1_PCS0: H1.7, IC7.97 (GPIO_AD_B0_11)
SPI1_PCS1: H1.8, IC7.88 (GPIO_AD_B1_04)
SPI1_PCS2: H1.20, IC7.87 (GPIO_AD_B1_05)
SPI1_PCS3: H1.19, IC7.84 (GPIO_AD_B1_06)
SPI1_SCK: H1.12, IC7.98 (GPIO_AD_B0_10)
UART1_RX: H1.4, IC7.101 (GPIO_AD_B0_07)
UART1_TX: H1.2, IC7.105 (GPIO_AD_B0_06)
UART3_RX: H1.52, IC7.93 (GPIO_AD_B0_15)
UART3_TX: H1.50, IC7.94 (GPIO_AD_B0_14)
UART4_RX: H1.3, IC7.79 (GPIO_AD_B1_11)
UART4_TX: H1.1, IC7.80 (GPIO_AD_B1_10)
USB_OTG1_CHD: IC7.66 (USB_OTG1_CHD_B), TP5.TP
VDD_HIGH_CAP: C23.2, C24.2, IC7.65 (VDD_HIGH_CAP)
VDD_SNVS_CAP: C21.2, IC7.56 (VDD_SNVS_CAP)
VDD_USB_3V: C4.2, C14.2, IC7.61 (VDD_USB_CAP)
VSD_3V3: C38.2, C49.2, C52.2, IC8.3 (VOUT), J1.4 (VDD)
WAKEUP: IC7.52 (WAKEUP), TP8.TP
XTALI: C39.2, IC7.67 (XTALI), R10.1, Y1.3 (XTAL_2)
XTALO: C40.2, IC7.68 (XTALO), Y1.1 (XTAL_1)

Notes on the sheet:
DETECTION PIN NOT NEEDED
DC JACK
PC 104 HEADERS
JTAG CONNECTOR
SDRAM
FLASH
CRYSTALS
32.768 KHz
24 MHz
SD CARD
OPTION TO SHORT
GND AND CHASSIS
