AA-CubeSat-Team/soci_pcb/projects/manufactured_brds/OBC_manufactured.brd

## EAGLE design projects/manufactured_brds/OBC_manufactured.brd (continued)

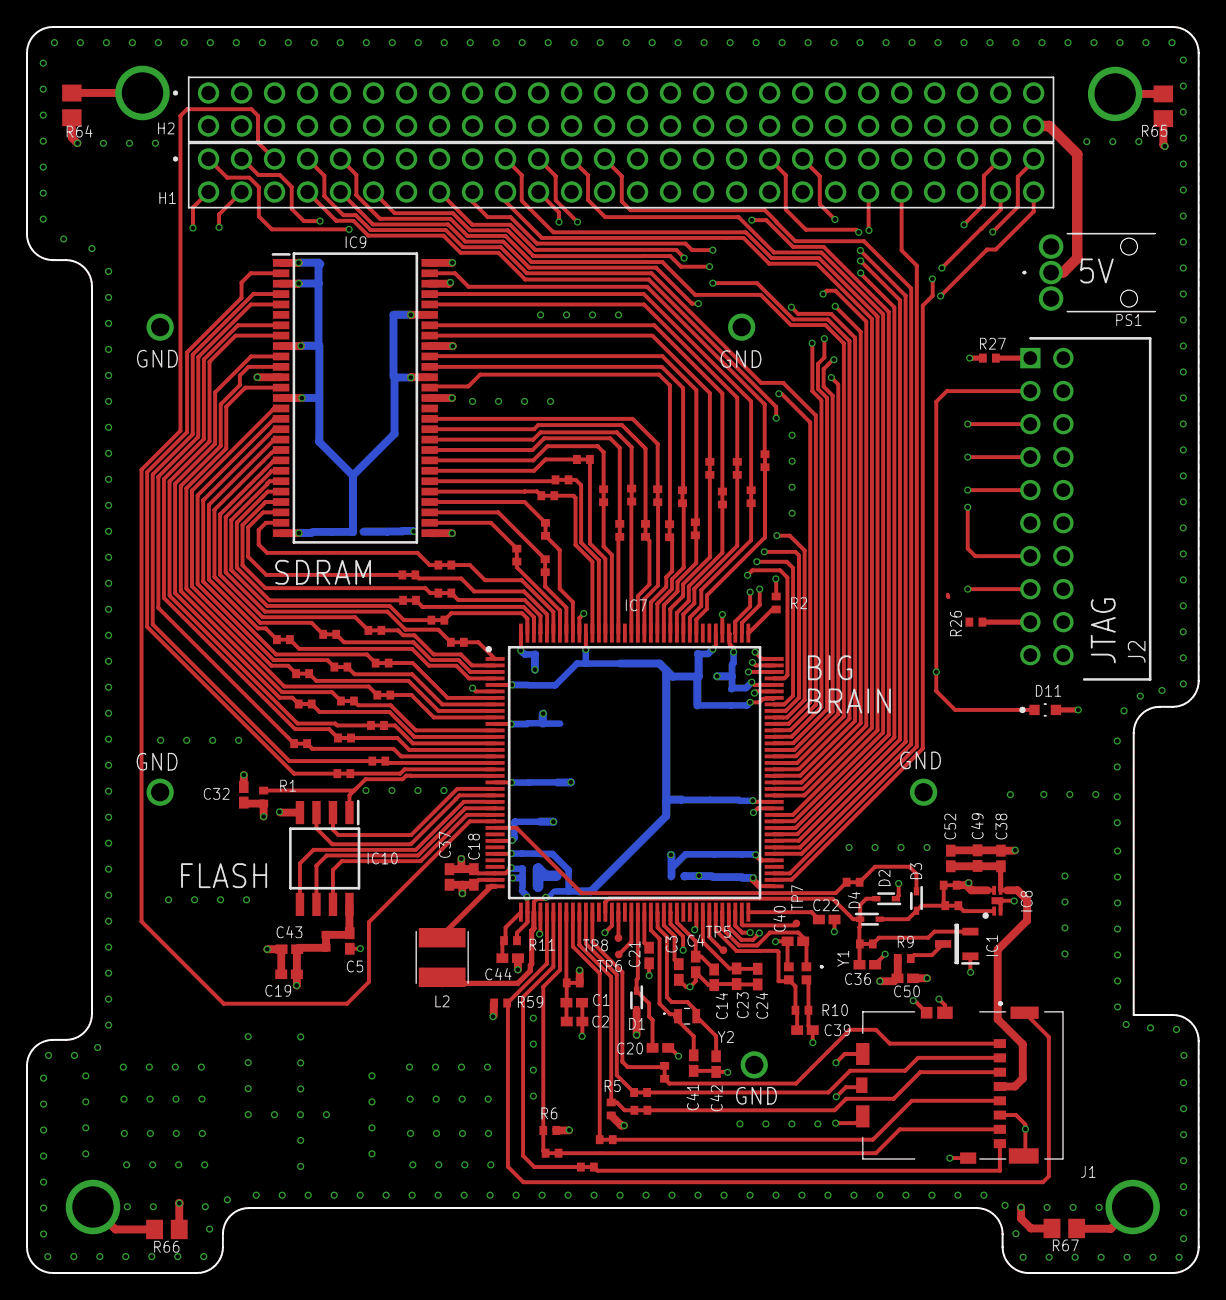
[picture p7: board OBC_manufactured.brd from above]

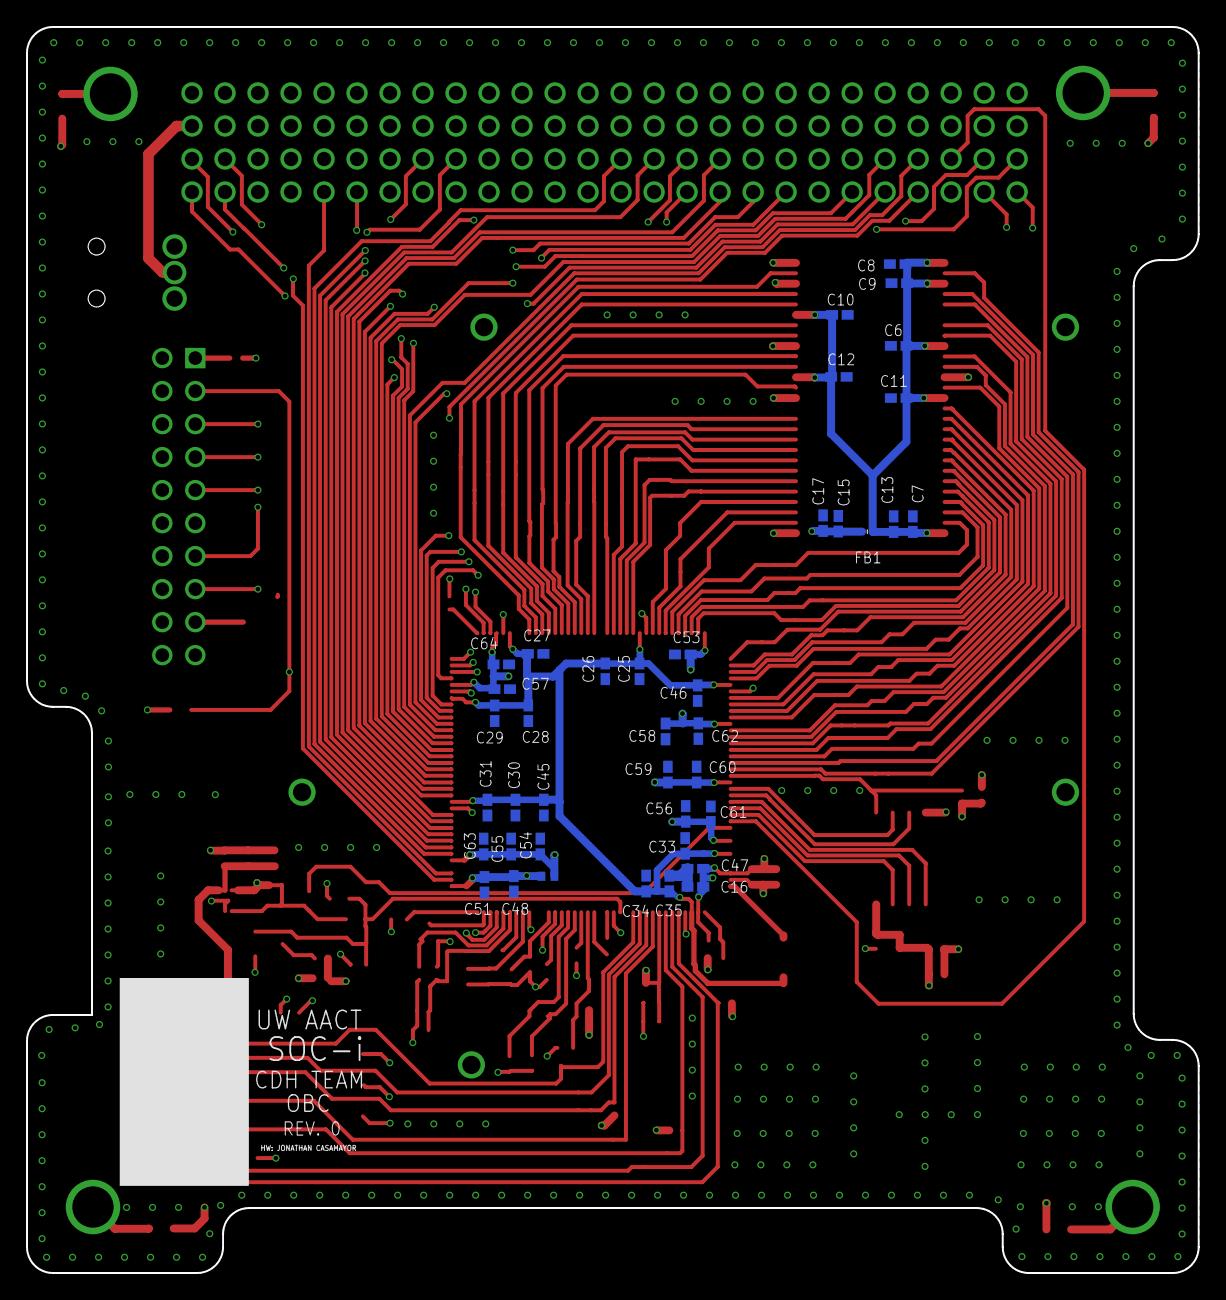
[picture p8: board OBC_manufactured.brd from below]

Board: 4 copper layers, 90.2 x 95.9 mm, 153 parts (40 on the bottom side), 113 nets.
