AA-CubeSat-Team/soci_pcb/projects/manufactured_brds/OB1_sensor_manufactured.brd

## EAGLE design projects/manufactured_brds/OB1_sensor_manufactured.brd (2021-12-10)

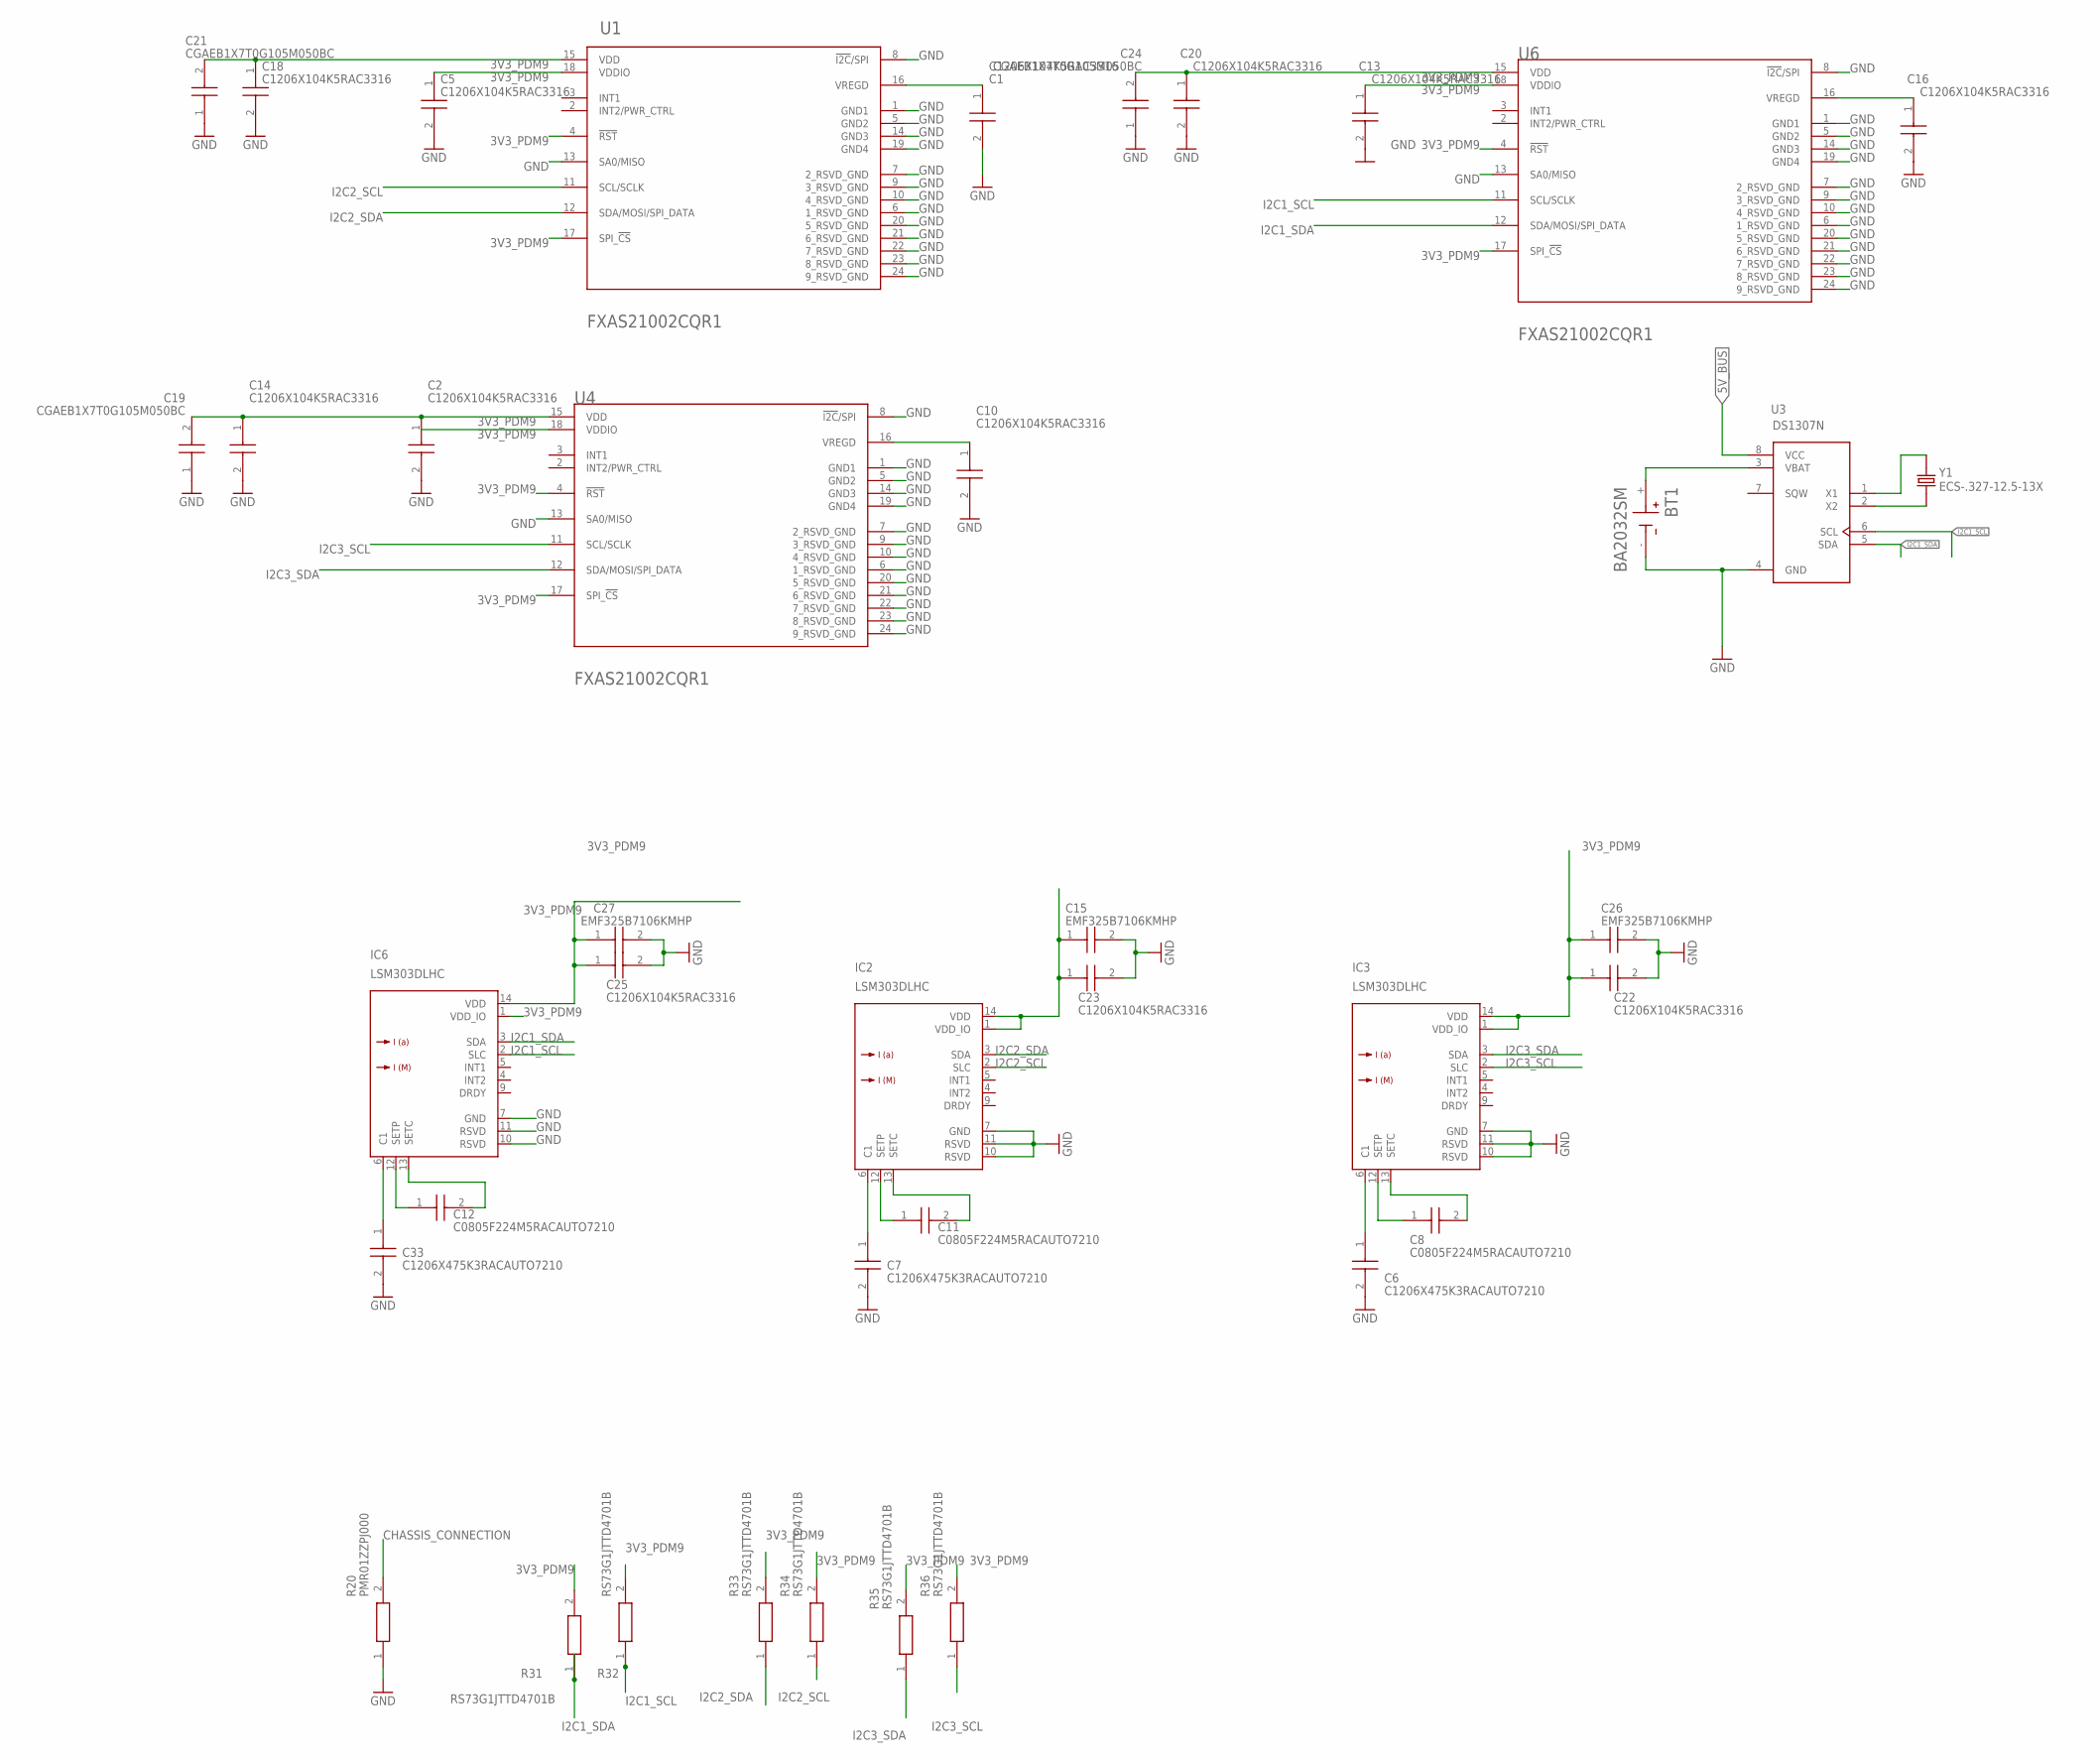
[picture p9: schematic OB1_sensor_manufactured.sch, sheet 1, Sensors]

Parts:
BT1: BA2032SM; BAT_BA2032SM
C1, C2, C5, C10, C13, C14, C16, C18, C20, C22, C23, C25: C1206X104K5RAC3316; CAPC3316X98N
C6, C7, C33: C1206X475K3RACAUTO7210; CAPC3316X195N
C8, C11, C12: C0805F224M5RACAUTO7210; CAPC2012X140N
C15, C26, C27: EMF325B7106KMHP; CAPC3225X270N
C19, C21, C24: CGAEB1X7T0G105M050BC; CAPC0611X68N
IC2, IC3, IC6: LSM303DLHC; LGA-14
R20: PMR01ZZPJ000; RESC1005X35N
R31, R32, R33, R34, R35, R36: RS73G1JTTD4701B; RESC1608X55N
U1, U4, U6: NXP_FXAS21002CQR1_EDITEDNXP_FXAS21002CQR1_0_0; NXP_FXAS21002CQR1_0_EDITED
U3: DS1307N; DIP762W47P254L991H457Q8
Y1: ECS-.327-12.5-13X; XTAL_ECS-.327-12.5-13X

Connections:
3V3_PDM9: C2.1, C5.1, C13.1, C14.1, C15.1, C18.1, C19.2, C20.1, C21.2, C22.1, C23.1, C24.2, C25.1, C26.1, C27.1, IC2.1 (VDD_IO), IC2.14 (VDD), IC3.1 (VDD_IO), IC3.14 (VDD), IC6.1 (VDD_IO), IC6.14 (VDD), R31.2, R32.2, R33.2, R34.2, R35.2, R36.2, U1.4 (!RST!), U1.15 (VDD), U1.17 (SPI_!CS!), U1.18 (VDDIO), U4.4 (!RST!), U4.15 (VDD), U4.17 (SPI_!CS!), U4.18 (VDDIO), U6.4 (!RST!), U6.15 (VDD), U6.17 (SPI_!CS!), U6.18 (VDDIO); also elsewhere on the board
5V_BUS: U3.8 (VCC); also elsewhere on the board
CHASSIS_CONNECTION: R20.2
GND: BT1.-, C1.2, C2.2, C5.2, C6.2, C7.2, C10.2, C13.2, C14.2, C15.2, C16.2, C18.2, C19.1, C20.2, C21.1, C22.2, C23.2, C24.1, C25.2, C26.2, C27.2, C33.2, IC2.7 (GND), IC2.10 (RSVD), IC2.11 (RSVD), IC3.7 (GND), IC3.10 (RSVD), IC3.11 (RSVD), IC6.7 (GND), IC6.10 (RSVD), IC6.11 (RSVD), R20.1, U1.1 (GND1), U1.5 (GND2), U1.6 (1_RSVD_GND), U1.7 (2_RSVD_GND), U1.8 (!I2C!/SPI), U1.9 (3_RSVD_GND), U1.10 (4_RSVD_GND), U1.13 (SA0/MISO), U1.14 (GND3), U1.19 (GND4), U1.20 (5_RSVD_GND), U1.21 (6_RSVD_GND), U1.22 (7_RSVD_GND), U1.23 (8_RSVD_GND), U1.24 (9_RSVD_GND), U3.4 (GND), U4.1 (GND1), U4.5 (GND2), U4.6 (1_RSVD_GND), U4.7 (2_RSVD_GND), U4.8 (!I2C!/SPI), U4.9 (3_RSVD_GND), U4.10 (4_RSVD_GND), U4.13 (SA0/MISO), U4.14 (GND3), U4.19 (GND4), U4.20 (5_RSVD_GND), U4.21 (6_RSVD_GND), U4.22 (7_RSVD_GND), U4.23 (8_RSVD_GND), U4.24 (9_RSVD_GND), U6.1 (GND1), U6.5 (GND2), U6.6 (1_RSVD_GND), U6.7 (2_RSVD_GND), U6.8 (!I2C!/SPI), U6.9 (3_RSVD_GND), U6.10 (4_RSVD_GND), U6.13 (SA0/MISO), U6.14 (GND3), U6.19 (GND4), U6.20 (5_RSVD_GND), U6.21 (6_RSVD_GND), U6.22 (7_RSVD_GND), U6.23 (8_RSVD_GND), U6.24 (9_RSVD_GND); also elsewhere on the board
I2C1_SCL: IC6.2 (SLC), R32.1, U3.6 (SCL), U6.11 (SCL/SCLK); also elsewhere on the board
I2C1_SDA: IC6.3 (SDA), R31.1, U3.5 (SDA), U6.12 (SDA/MOSI/SPI_DATA); also elsewhere on the board
I2C2_SCL: IC2.2 (SLC), R34.1, U1.11 (SCL/SCLK); also elsewhere on the board
I2C2_SDA: IC2.3 (SDA), R33.1, U1.12 (SDA/MOSI/SPI_DATA); also elsewhere on the board
I2C3_SCL: IC3.2 (SLC), R36.1, U4.11 (SCL/SCLK); also elsewhere on the board
I2C3_SDA: IC3.3 (SDA), R35.1, U4.12 (SDA/MOSI/SPI_DATA); also elsewhere on the board
unnamed: C6.1, IC3.6 (C1)
unnamed: C8.1, IC3.12 (SETP)
unnamed: C8.2, IC3.13 (SETC)
unnamed: C11.1, IC2.12 (SETP)
unnamed: C11.2, IC2.13 (SETC)
unnamed: C7.1, IC2.6 (C1)
unnamed: C12.1, IC6.12 (SETP)
unnamed: C12.2, IC6.13 (SETC)
unnamed: C33.1, IC6.6 (C1)
unnamed: U3.2 (X2), Y1.2
unnamed: U3.1 (X1), Y1.1
unnamed: BT1.+, U3.3 (VBAT)
unnamed: C10.1, U4.16 (VREGD)
unnamed: C1.1, U1.16 (VREGD)
unnamed: C16.1, U6.16 (VREGD)

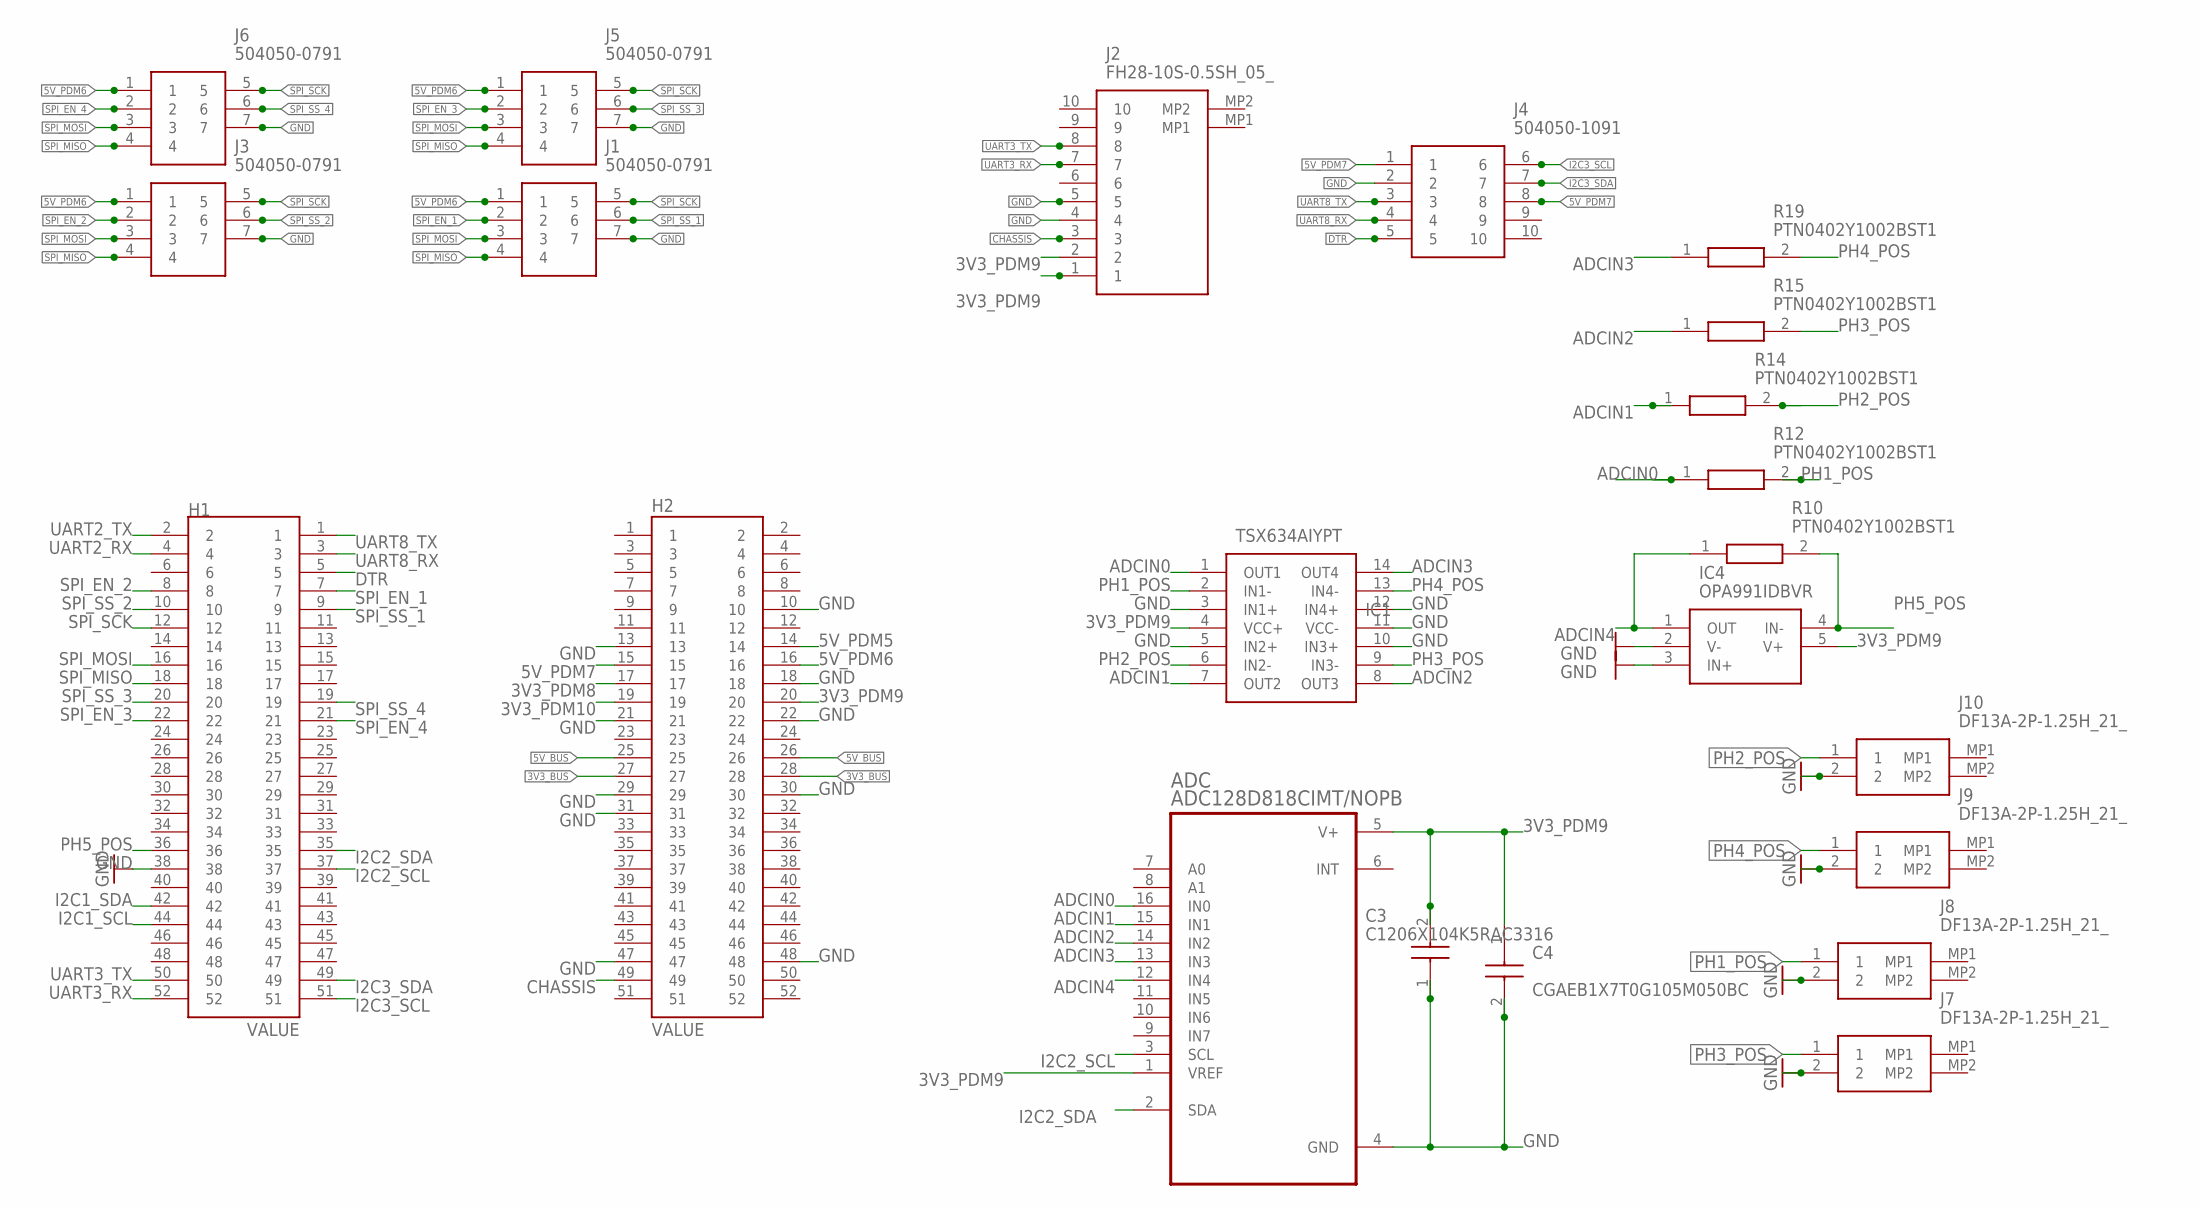
[picture p10: schematic OB1_sensor_manufactured.sch, sheet 2]

Parts:
ADC: ADC128D818CIMT/NOPB; SOP65P640X120-16N
C3: C1206X104K5RAC3316; CAPC3316X98N
C4: CGAEB1X7T0G105M050BC; CAPC0611X68N
H1, H2: ESQ-126-39-G-D; SAMTEC_ESQ-126-39-G-D
IC1: TSX634AIYPT; SOP65P640X120-14N
IC4: OPA991IDBVR; SOT95P280X145-5N
J1, J3, J5, J6: 504050-0791
J2: FH28-10S-0.5SH_05_; FH2810S05SH05
J4: 504050-1091
J7, J8, J9, J10: DF13A-2P-1.25H_21_; DF13A2P125H21
R10, R12, R14, R15, R19: PTN0402Y1002BST1; RESC1106X84N

Connections:
3V3_BUS: H2.27, H2.28
3V3_PDM8: H2.17
3V3_PDM9: ADC.1 (VREF), ADC.5 (V+), C3.2, C4.1, H2.20, IC1.4 (VCC+), IC4.5 (V+), J2.1, J2.2; also elsewhere on the board
3V3_PDM10: H2.19
5V_BUS: H2.25, H2.26; also elsewhere on the board
5V_PDM5: H2.14
5V_PDM6: H2.16, J1.1, J3.1, J5.1, J6.1
5V_PDM7: H2.15, J4.1, J4.8
ADCIN0: ADC.16 (IN0), IC1.1 (OUT1), R12.1
ADCIN1: ADC.15 (IN1), IC1.7 (OUT2), R14.1
ADCIN2: ADC.14 (IN2), IC1.8 (OUT3), R15.1
ADCIN3: ADC.13 (IN3), IC1.14 (OUT4), R19.1
ADCIN4: ADC.12 (IN4), IC4.1 (OUT), R10.1
CHASSIS: H2.49, J2.3
DTR: H1.5, J4.5
GND: ADC.4 (GND), C3.1, C4.2, H1.38, H2.10, H2.13, H2.18, H2.21, H2.22, H2.29, H2.30, H2.31, H2.47, H2.48, IC1.3 (IN1+), IC1.5 (IN2+), IC1.10 (IN3+), IC1.11 (VCC-), IC1.12 (IN4+), IC4.2 (V-), IC4.3 (IN+), J1.7, J2.4, J2.5, J3.7, J4.2, J5.7, J6.7, J7.2, J8.2, J9.2, J10.2; also elsewhere on the board
I2C1_SCL: H1.44; also elsewhere on the board
I2C1_SDA: H1.42; also elsewhere on the board
I2C2_SCL: ADC.3 (SCL), H1.37; also elsewhere on the board
I2C2_SDA: ADC.2 (SDA), H1.35; also elsewhere on the board
I2C3_SCL: H1.51, J4.6; also elsewhere on the board
I2C3_SDA: H1.49, J4.7; also elsewhere on the board
PH1_POS: IC1.2 (IN1-), J8.1, R12.2
PH2_POS: IC1.6 (IN2-), J10.1, R14.2
PH3_POS: IC1.9 (IN3-), J7.1, R15.2
PH4_POS: IC1.13 (IN4-), J9.1, R19.2
PH5_POS: H1.36, IC4.4 (IN-), R10.2
SPI_EN_1: H1.7, J1.2
SPI_EN_2: H1.8, J3.2
SPI_EN_3: H1.22, J5.2
SPI_EN_4: H1.21, J6.2
SPI_MISO: H1.18, J1.4, J3.4, J5.4, J6.4
SPI_MOSI: H1.16, J1.3, J3.3, J5.3, J6.3
SPI_SCK: H1.12, J1.5, J3.5, J5.5, J6.5
SPI_SS_1: H1.9, J1.6
SPI_SS_2: H1.10, J3.6
SPI_SS_3: H1.20, J5.6
SPI_SS_4: H1.19, J6.6
UART2_RX: H1.4
UART2_TX: H1.2
UART3_RX: H1.52, J2.7
UART3_TX: H1.50, J2.8
UART8_RX: H1.3, J4.4
UART8_TX: H1.1, J4.3

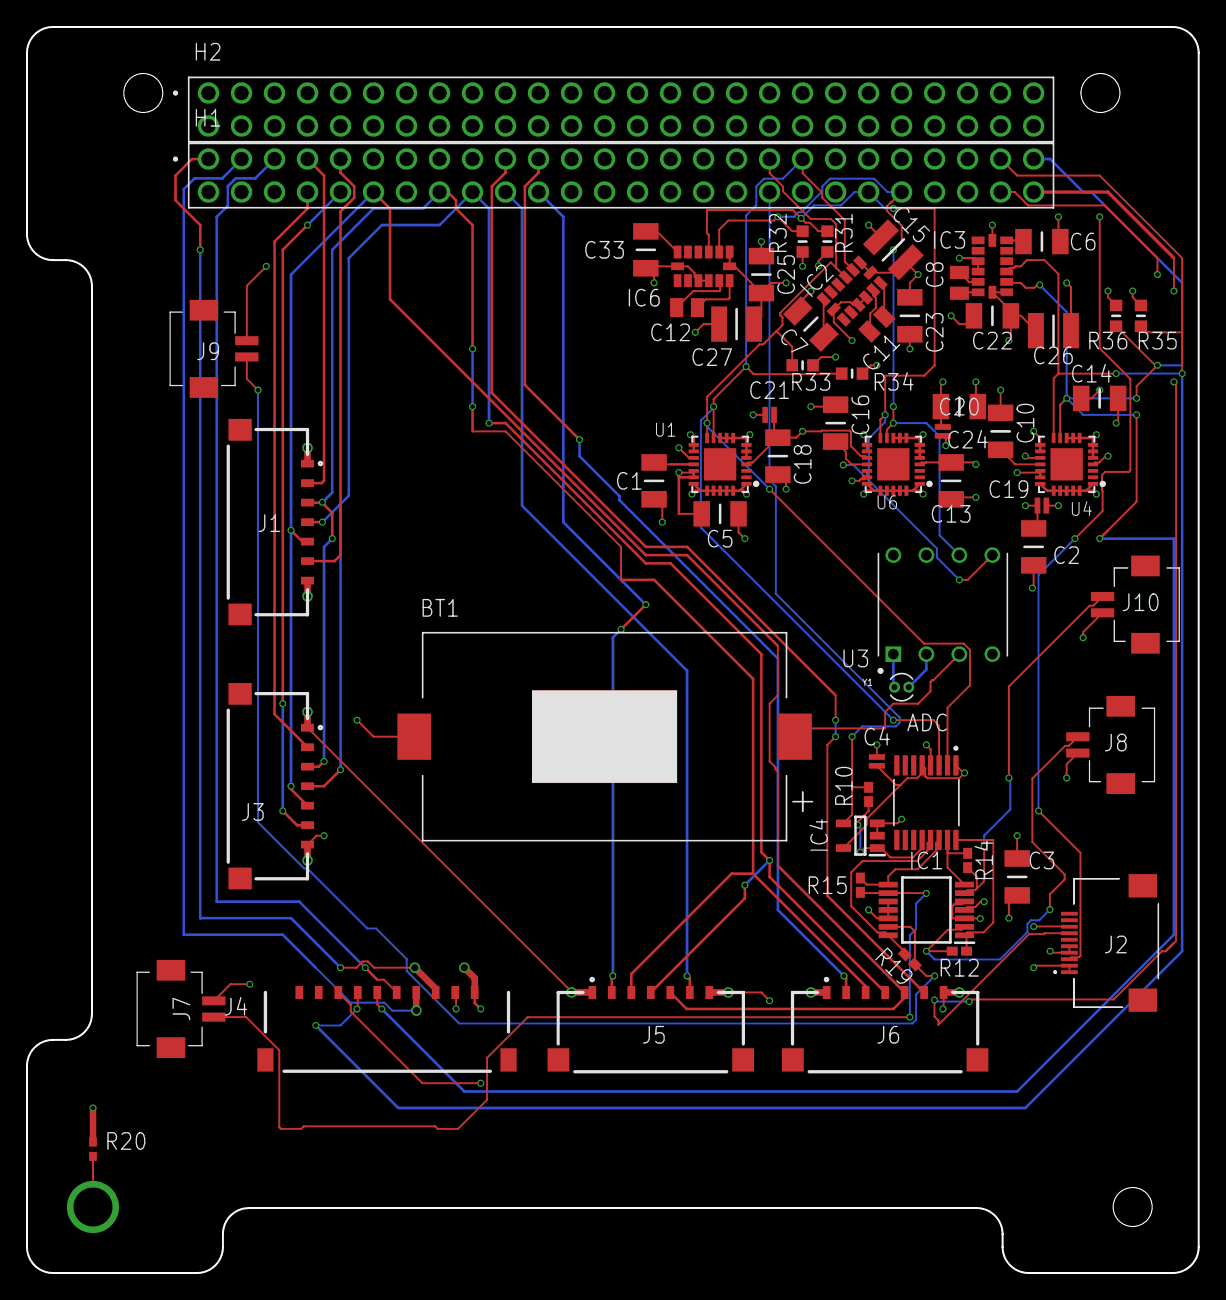
[picture p11: board OB1_sensor_manufactured.brd from above]

Board: 4 copper layers, 90.2 x 95.9 mm, 62 parts (0 on the bottom side), 54 nets.
