AA-CubeSat-Team/soci_pcb/projects/eps_flatsat_module/eps_flatsat_module.brd

## EAGLE design projects/eps_flatsat_module/eps_flatsat_module.brd (2020-09-15)

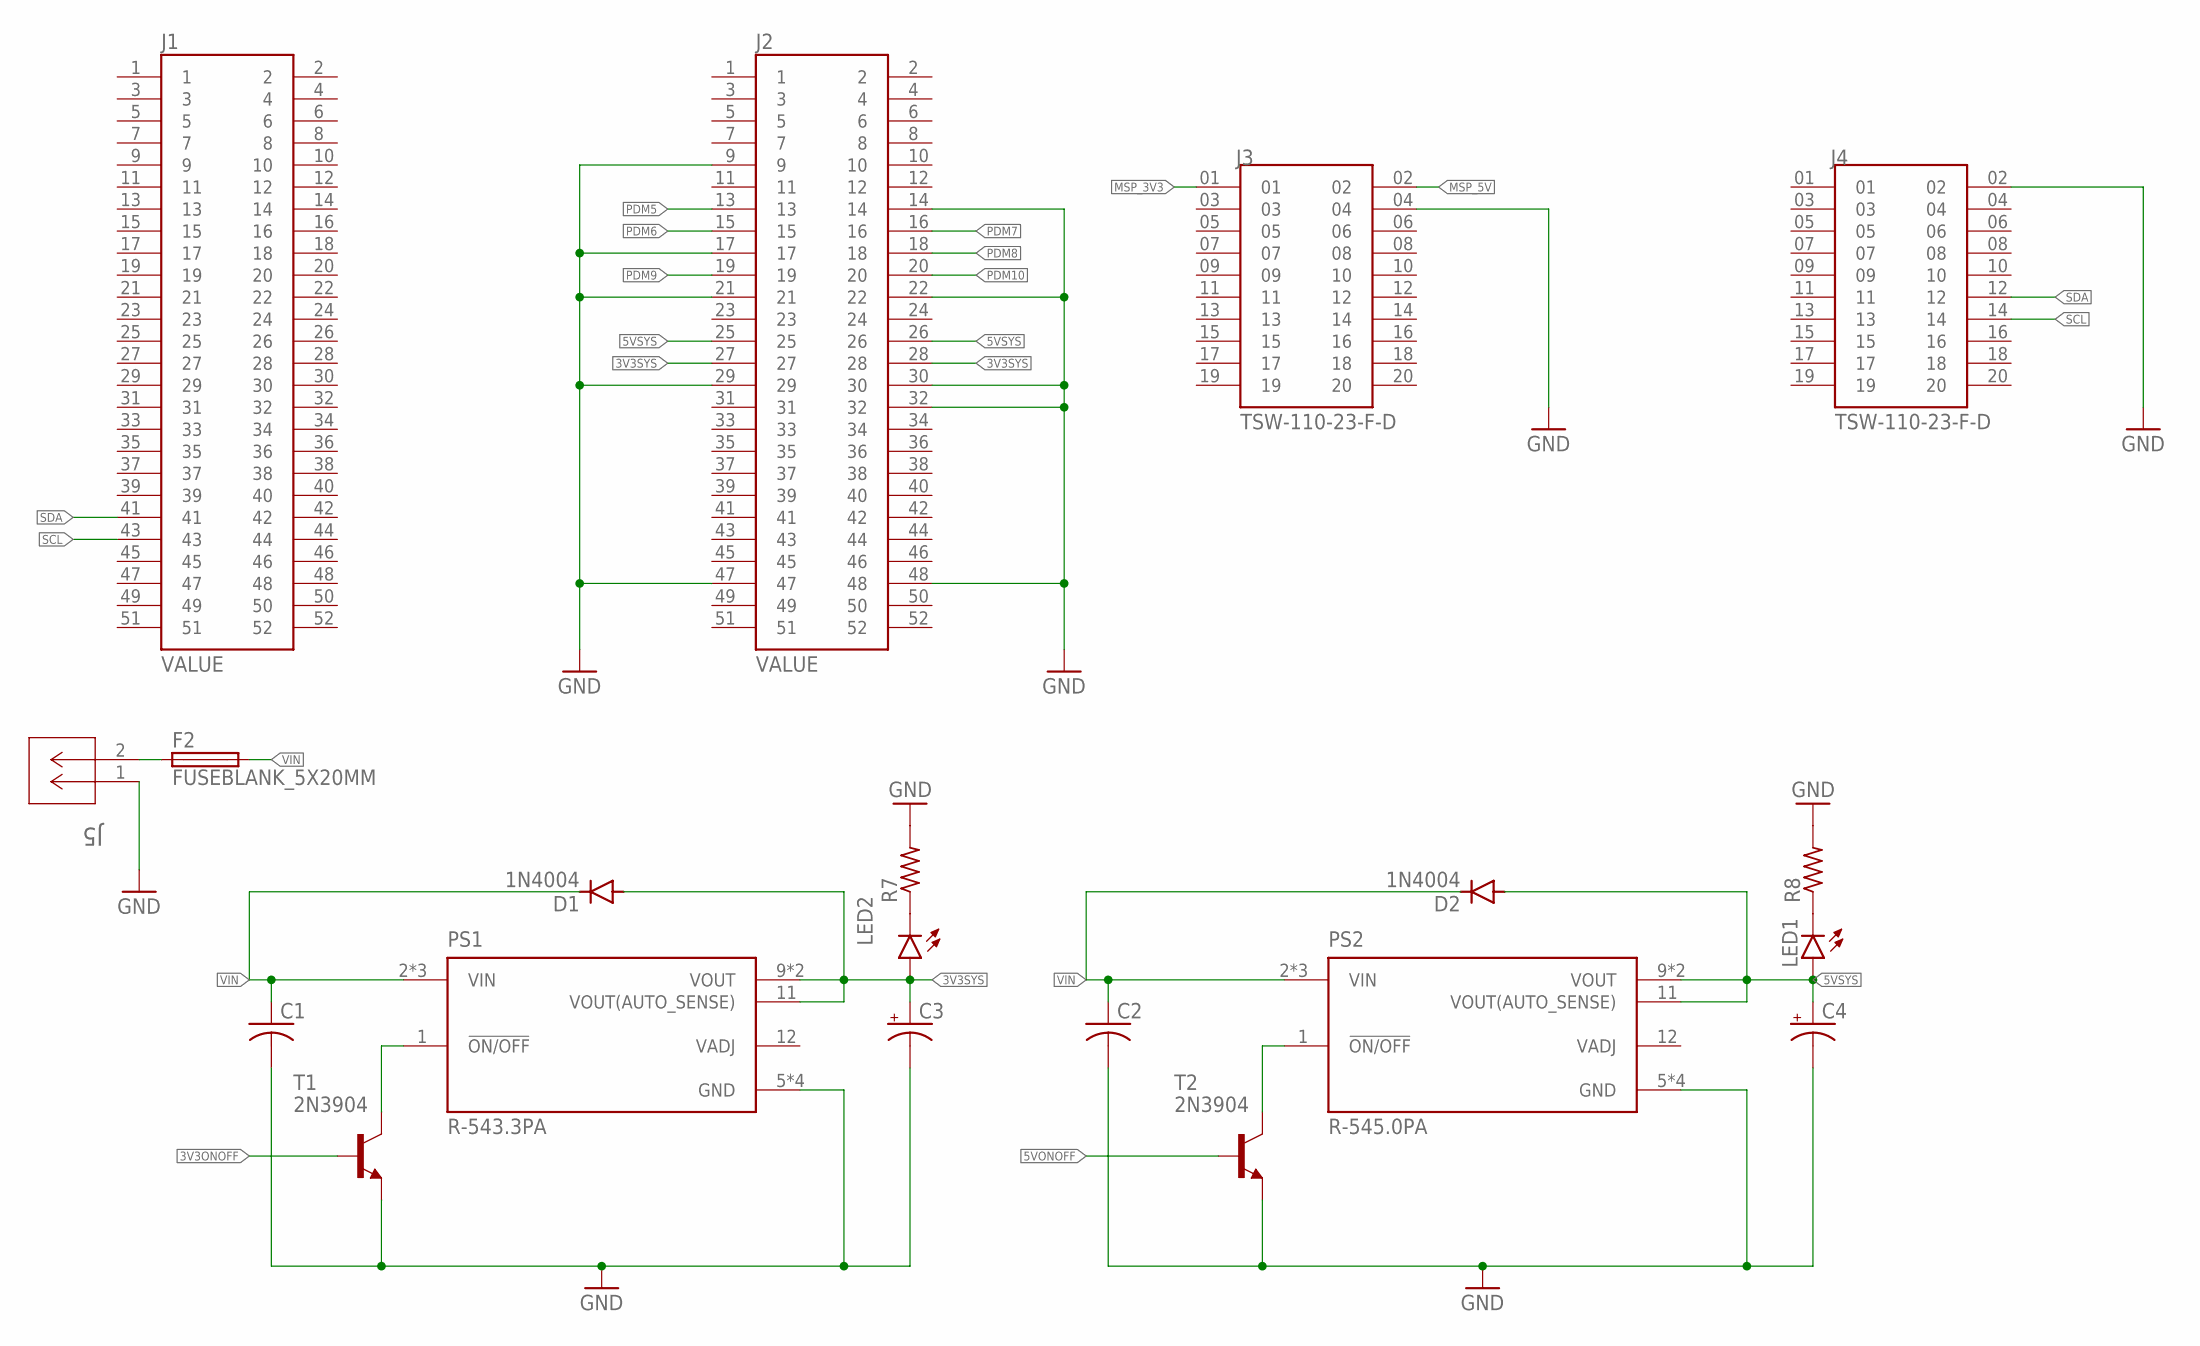
[picture p12: schematic eps_flatsat_module.sch, sheet 1]

Parts:
C1, C2: C-USC0805; C0805
C3, C4: CPOL-USE2.5-6; E2,5-6
D1, D2: 1N4004; DO41-10
F2: FUSEBLANK_5X20MM; FUSE_HOLDER_5X20MM
J1, J2: ESQ-126-39-G-D; SAMTEC_ESQ-126-39-G-D
J3, J4: TSW-110-23-F-D; SAMTEC_TSW-110-23-F-D
J5: 1985881; CONN_1715022_PXC
LED1, LED2: LEDCHIPLED_0805; CHIPLED_0805
PS1: R-543.3PA; CONV_R-543.3PA
PS2: R-545.0PA; CONV_R-545.0PA
R7, R8: R-US_R0805; R0805
T1, T2: 2N3904; TO92

Connections:
3V3ONOFF: T1.2 (B)
3V3SYS: C3.+, D1.A, J2.27, J2.28, LED2.A, PS1.9 (VOUT), PS1.10 (VOUT), PS1.11 (VOUT(AUTO_SENSE)); also elsewhere on the board
5VONOFF: T2.2 (B)
5VSYS: C4.+, D2.A, J2.25, J2.26, LED1.A, PS2.9 (VOUT), PS2.10 (VOUT), PS2.11 (VOUT(AUTO_SENSE)); also elsewhere on the board
GND: C1.2, C2.2, C3.-, C4.-, J2.9, J2.14, J2.17, J2.21, J2.22, J2.29, J2.30, J2.32, J2.47, J2.48, J3.04, J4.02, J5.1, PS1.5 (GND), PS1.6 (GND), PS1.7 (GND), PS1.8 (GND), PS2.5 (GND), PS2.6 (GND), PS2.7 (GND), PS2.8 (GND), R7.2, R8.2, T1.3 (E), T2.3 (E); also elsewhere on the board
MSP_3V3: J3.01
MSP_5V: J3.02
unnamed: PS1.1 (!ON/OFF), T1.1 (C)
unnamed: PS2.1 (!ON/OFF), T2.1 (C)
unnamed: LED1.C, R8.1
unnamed: LED2.C, R7.1
unnamed: F2.1, J5.2
PDM5: J2.13; also elsewhere on the board
PDM6: J2.15; also elsewhere on the board
PDM7: J2.16; also elsewhere on the board
PDM8: J2.18; also elsewhere on the board
PDM9: J2.19; also elsewhere on the board
PDM10: J2.20; also elsewhere on the board
SCL: J1.43, J4.14
SDA: J1.41, J4.12
VIN: C1.1, C2.1, D1.C, D2.C, F2.2, PS1.2 (VIN), PS1.3 (VIN), PS1.4 (VIN), PS2.2 (VIN), PS2.3 (VIN), PS2.4 (VIN)

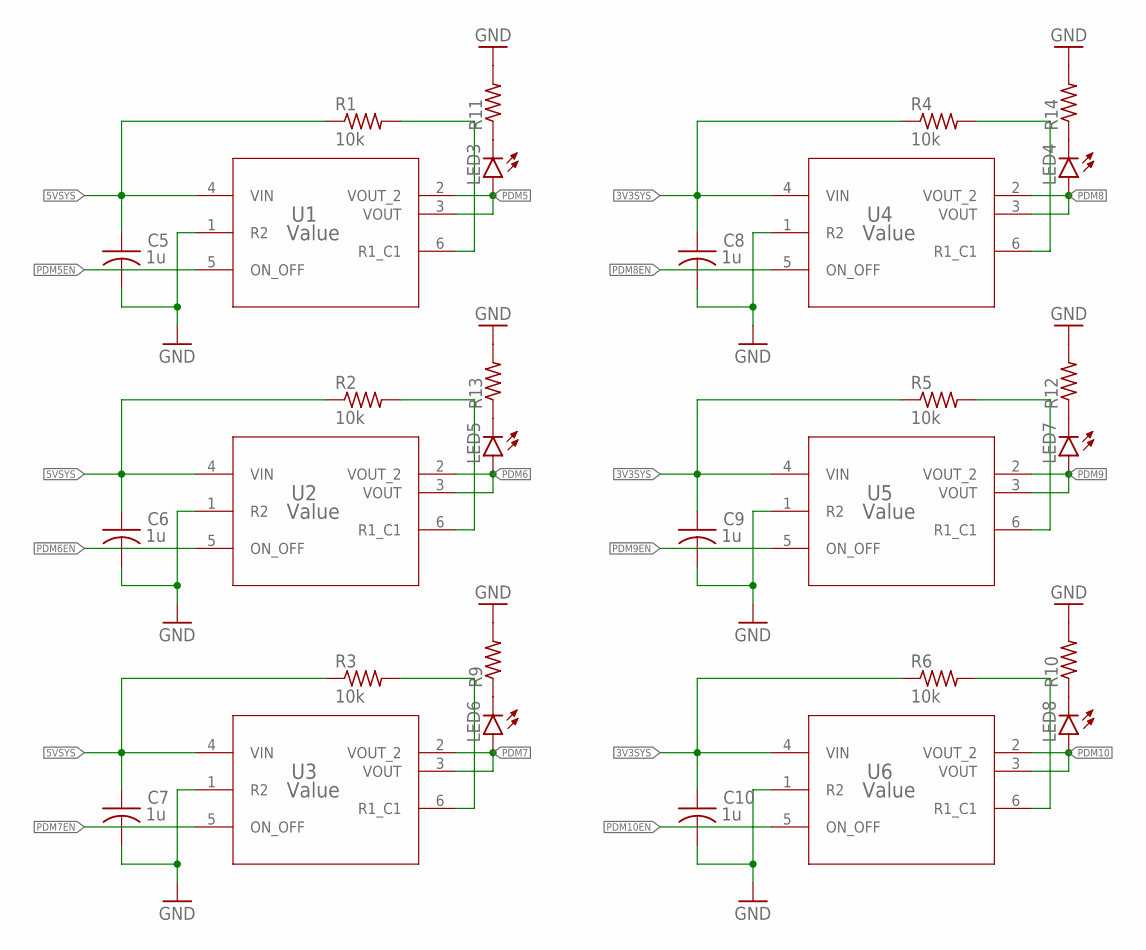
[picture p13: schematic eps_flatsat_module.sch, sheet 2]

Parts:
C5, C6, C7, C8, C9, C10: 1u; C0805
LED3, LED4, LED5, LED6, LED7, LED8: LEDCHIPLED_0805; CHIPLED_0805
R1, R2, R3, R4, R5, R6: 10k; R0805
R9, R10, R11, R12, R13, R14: R-US_R0805; R0805
U1, U2, U3, U4, U5, U6: Value; DDC0006A_N

Connections:
3V3SYS: C8.1, C9.1, C10.1, R4.1, R5.1, R6.1, U4.4 (VIN), U5.4 (VIN), U6.4 (VIN); also elsewhere on the board
5VSYS: C5.1, C6.1, C7.1, R1.1, R2.1, R3.1, U1.4 (VIN), U2.4 (VIN), U3.4 (VIN); also elsewhere on the board
GND: C5.2, C6.2, C7.2, C8.2, C9.2, C10.2, R9.2, R10.2, R11.2, R12.2, R13.2, R14.2, U1.1 (R2), U2.1 (R2), U3.1 (R2), U4.1 (R2), U5.1 (R2), U6.1 (R2); also elsewhere on the board
unnamed: R1.2, U1.6 (R1_C1)
unnamed: R2.2, U2.6 (R1_C1)
unnamed: R3.2, U3.6 (R1_C1)
unnamed: R4.2, U4.6 (R1_C1)
unnamed: R5.2, U5.6 (R1_C1)
unnamed: R6.2, U6.6 (R1_C1)
unnamed: LED6.C, R9.1
unnamed: LED3.C, R11.1
unnamed: LED4.C, R14.1
unnamed: LED7.C, R12.1
unnamed: LED5.C, R13.1
unnamed: LED8.C, R10.1
PDM5: LED3.A, U1.2 (VOUT_2), U1.3 (VOUT); also elsewhere on the board
PDM5EN: U1.5 (ON_OFF)
PDM6: LED5.A, U2.2 (VOUT_2), U2.3 (VOUT); also elsewhere on the board
PDM6EN: U2.5 (ON_OFF)
PDM7: LED6.A, U3.2 (VOUT_2), U3.3 (VOUT); also elsewhere on the board
PDM7EN: U3.5 (ON_OFF)
PDM8: LED4.A, U4.2 (VOUT_2), U4.3 (VOUT); also elsewhere on the board
PDM8EN: U4.5 (ON_OFF)
PDM9: LED7.A, U5.2 (VOUT_2), U5.3 (VOUT); also elsewhere on the board
PDM9EN: U5.5 (ON_OFF)
PDM10: LED8.A, U6.2 (VOUT_2), U6.3 (VOUT); also elsewhere on the board
PDM10EN: U6.5 (ON_OFF)

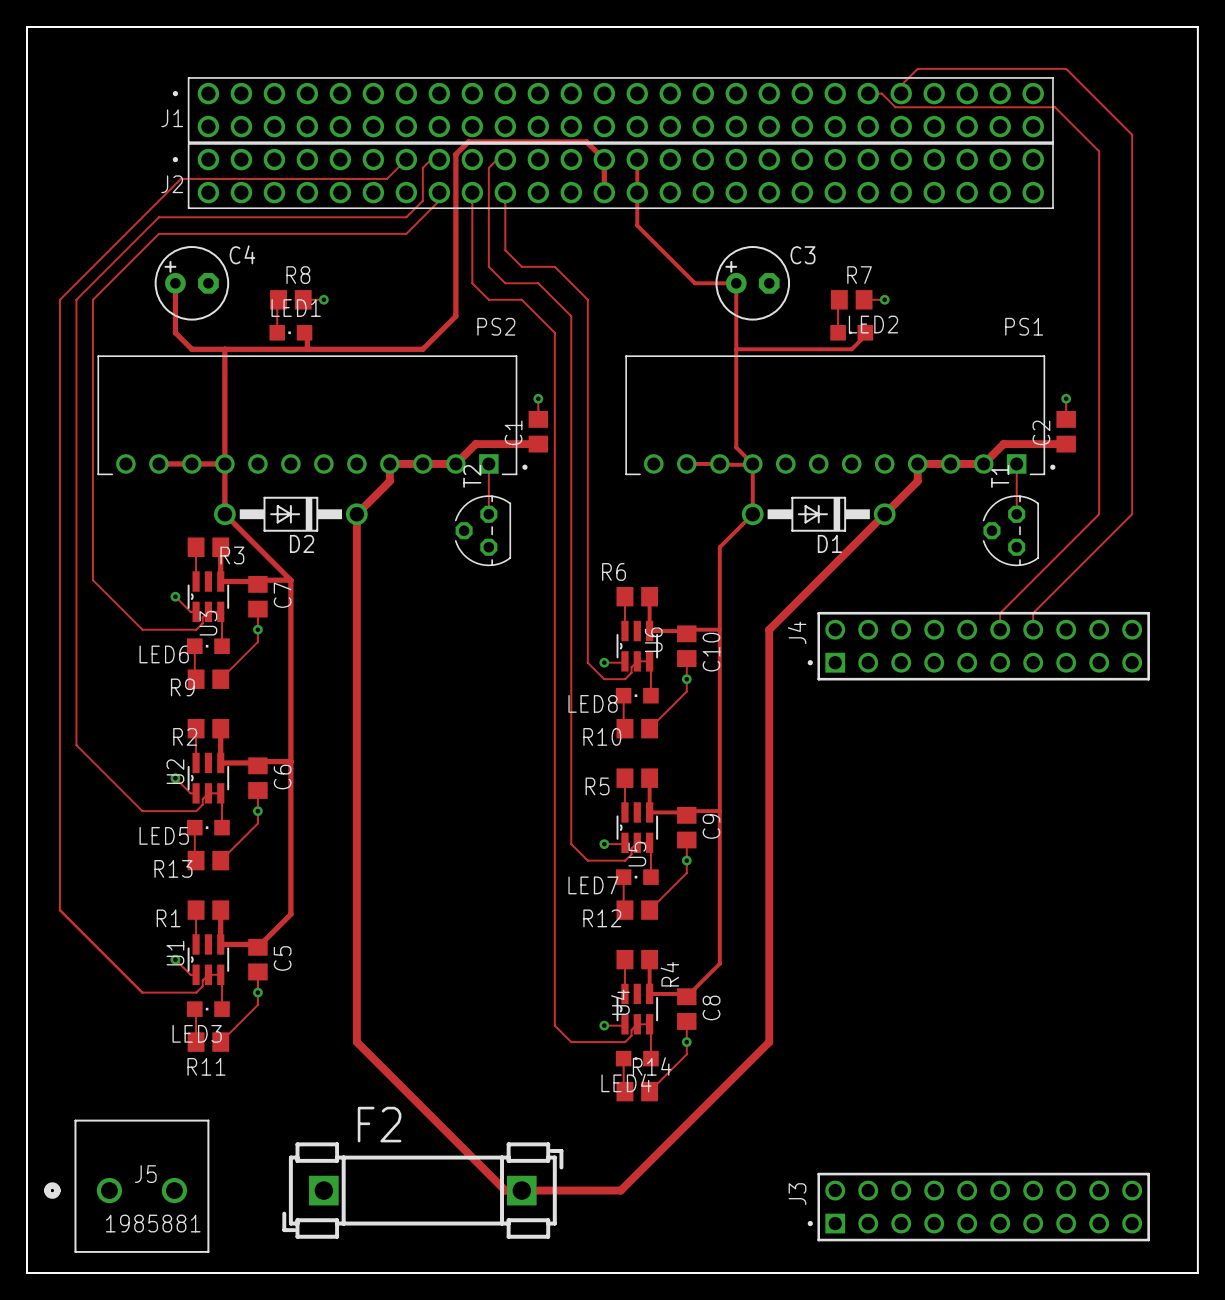
[picture p14: board eps_flatsat_module.brd from above]

Board: 2 copper layers, 90.2 x 95.9 mm, 50 parts (0 on the bottom side), 29 nets.
