AA-CubeSat-Team/soci_pcb/projects/real_time_clock_testboard/rtc.brd

## EAGLE design projects/real_time_clock_testboard/rtc.brd (continued)

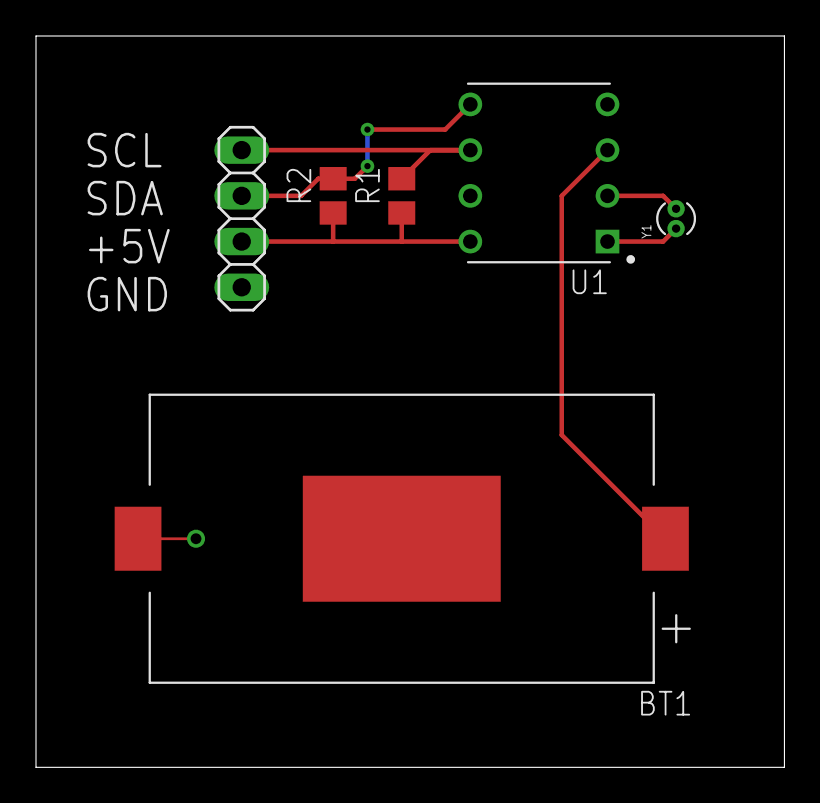
[picture p16: board rtc.brd from above]

Board: 2 copper layers, 41.6 x 40.6 mm, 6 parts (0 on the bottom side), 7 nets.
