AA-CubeSat-Team/soci_pcb/projects/CIA_board/old_versions/control_boardv9.brd

## EAGLE design projects/CIA_board/old_versions/control_boardv9.brd (2021-11-12, an earlier design)

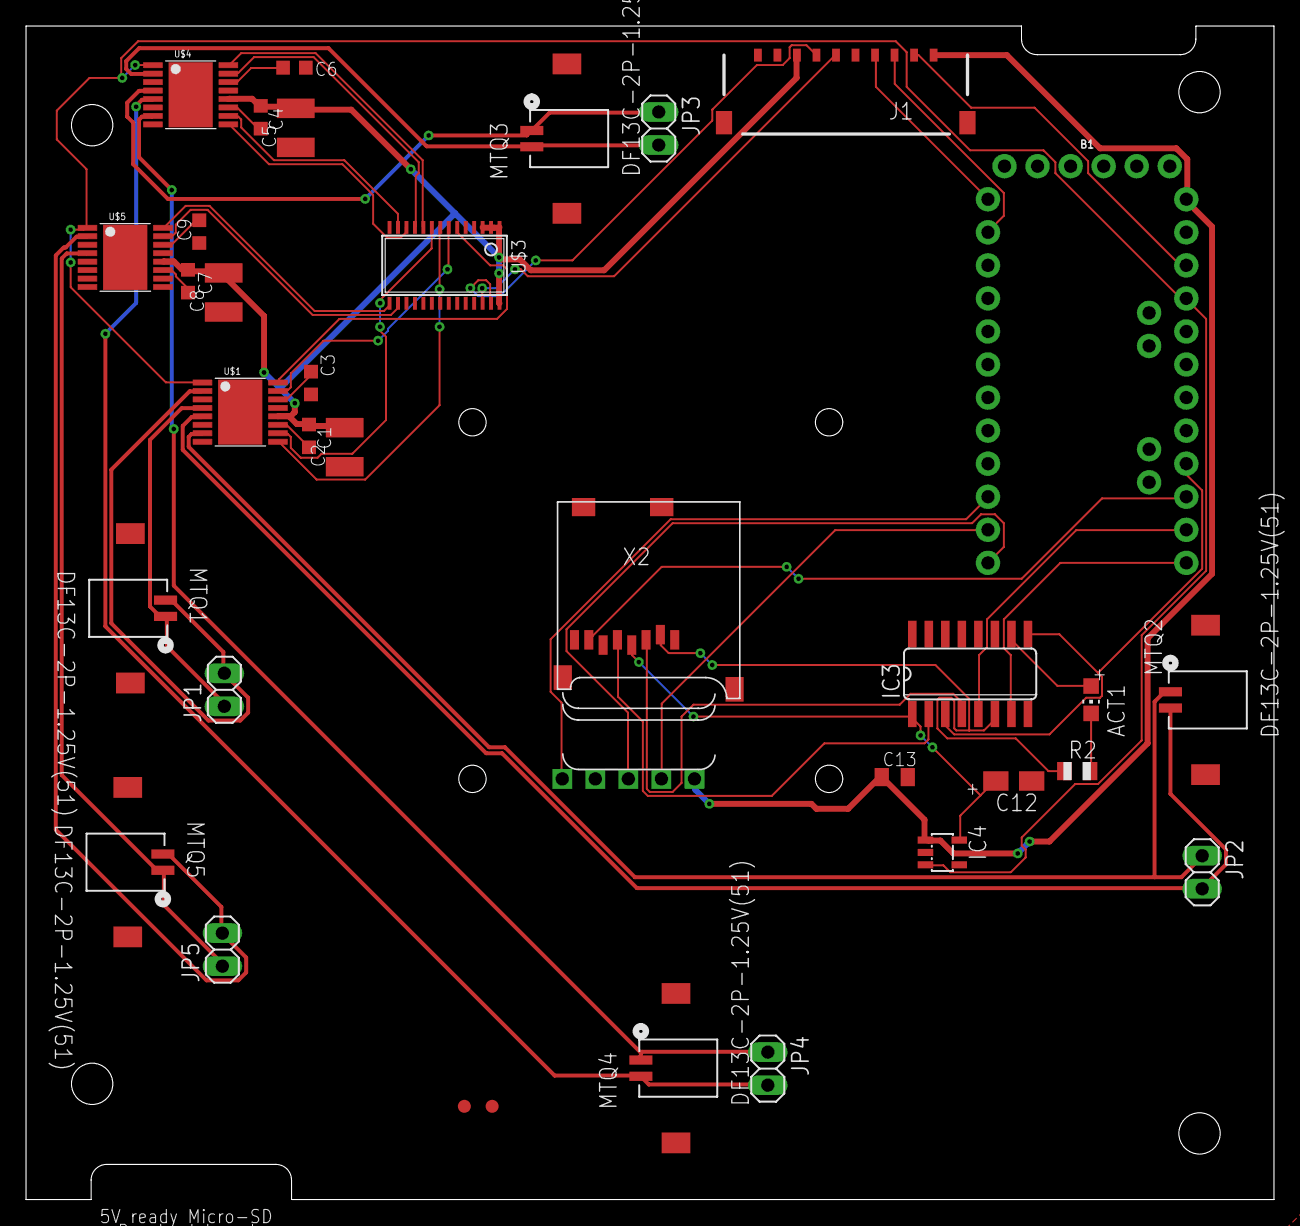
[picture p17: board control_boardv9.brd from above]

Board: 2 copper layers, 95.9 x 90.2 mm, 35 parts (0 on the bottom side), 48 nets.

Parts:
ACT1: RED; CHIP-LED0805
B1: ARDUINO_PRO_MINI
C1, C4, C7: 0.01uF; C0603K
C2, C5, C8: 10uF; C1210K
C3, C6, C9: 2.2uF; C0603K
C12: 10uF/10V; A/3216-18R
C13: 0.1uF; C0805K
IC3: 4050D; SO16
IC4: LP298XS; SOT23-5L
J1: 504050-1091
JP1, JP2, JP3, JP4, JP5: 1X02
MTQ1, MTQ2, MTQ3, MTQ4, MTQ5: DF13C-2P-1.25V(51); CON2_1X2_U_DF13
R2: 1K; R0805
U$1, U$4, U$5: DRV8833PWP; HTSSOP16
U$2: UCAM-III
U$3: PCA9685PW; TSSOP28
U$6, U$7: FIDUCIAL; FIDUCIAL_1MM
X2: MICROSD

Connections:
5V_1: C1.1, C2.2, C4.1, C5.2, C7.1, C8.2, J1.8, U$1.P12, U$3.1, U$3.2, U$3.3, U$3.28, U$4.P12, U$5.P12
5V_2: B1.24, C13.1, IC4.1, J1.1, U$2.1
+3V3: C12.+, IC3.1, IC4.5, X2.4
CLK: B1.16, IC3.3, IC3.9
CS: B1.13, IC3.7
DI: B1.14, IC3.5
DO: B1.15, X2.7
GND: B1.4, B1.23, C2.1, C3.1, C5.1, C6.1, C8.1, C9.1, C12.-, C13.2, IC3.8, IC3.11, IC3.14, IC4.2, J1.9, U$1.P3, U$1.P6, U$1.P13, U$2.4, U$3.4, U$3.5, U$3.14, U$3.23, U$3.24, U$3.25, U$4.P3, U$4.P6, U$4.P13, U$5.P3, U$5.P6, U$5.P13, X2.6, X2.MT1, X2.MT2
MTQ1_A: U$1.P16, U$3.6
MTQ1_B: U$1.P15, U$3.7
MTQ2_A: U$1.P9, U$3.8
MTQ2_B: U$1.P10, U$3.9
MTQ3_A: U$3.10, U$4.P16
MTQ3_B: U$3.11, U$4.P15
MTQ4_A: U$3.12, U$4.P9
MTQ4_B: U$3.13, U$4.P10
MTQ5_A: U$3.15, U$5.P16
MTQ5_B: U$3.16, U$5.P15
unnamed: JP3.2, MTQ3.2, U$4.P2
unnamed: C3.2, U$1.P14
unnamed: JP1.1, MTQ1.1, U$1.P4
unnamed: JP1.2, MTQ1.2, U$1.P2
unnamed: JP2.1, MTQ2.1, U$1.P7
unnamed: JP2.2, MTQ2.2, U$1.P5
unnamed: C1.2, U$1.P11
unnamed: JP4.1, MTQ4.1, U$4.P7
unnamed: JP4.2, MTQ4.2, U$4.P5
unnamed: C6.2, U$4.P14
unnamed: C4.2, U$4.P11
unnamed: JP3.1, MTQ3.1, U$4.P4
unnamed: JP5.2, MTQ5.2, U$5.P2
unnamed: C9.2, U$5.P14
unnamed: C7.2, U$5.P11
unnamed: JP5.1, MTQ5.1, U$5.P4
unnamed: ACT1.A, IC3.10
unnamed: IC3.2, X2.5
unnamed: IC3.6, R2.1, X2.2
unnamed: ACT1.C, R2.2
unnamed: IC3.4, X2.3
unnamed: B1.10, U$2.5
RST: B1.22, J1.2
RX: B1.12, U$2.3
RXI: B1.2, J1.3
SCL: J1.6, U$3.26
SDA: J1.7, U$3.27
TX: B1.11, U$2.2
TXO: B1.1, J1.4
VCC: B1.21, IC4.3, U$1.P1, U$4.P1, U$5.P1
