AA-CubeSat-Team/soci_pcb/projects/CIA_board/old_versions/control_boardv4.brd

## EAGLE design projects/CIA_board/old_versions/control_boardv4.brd (2021-11-12, an earlier design)

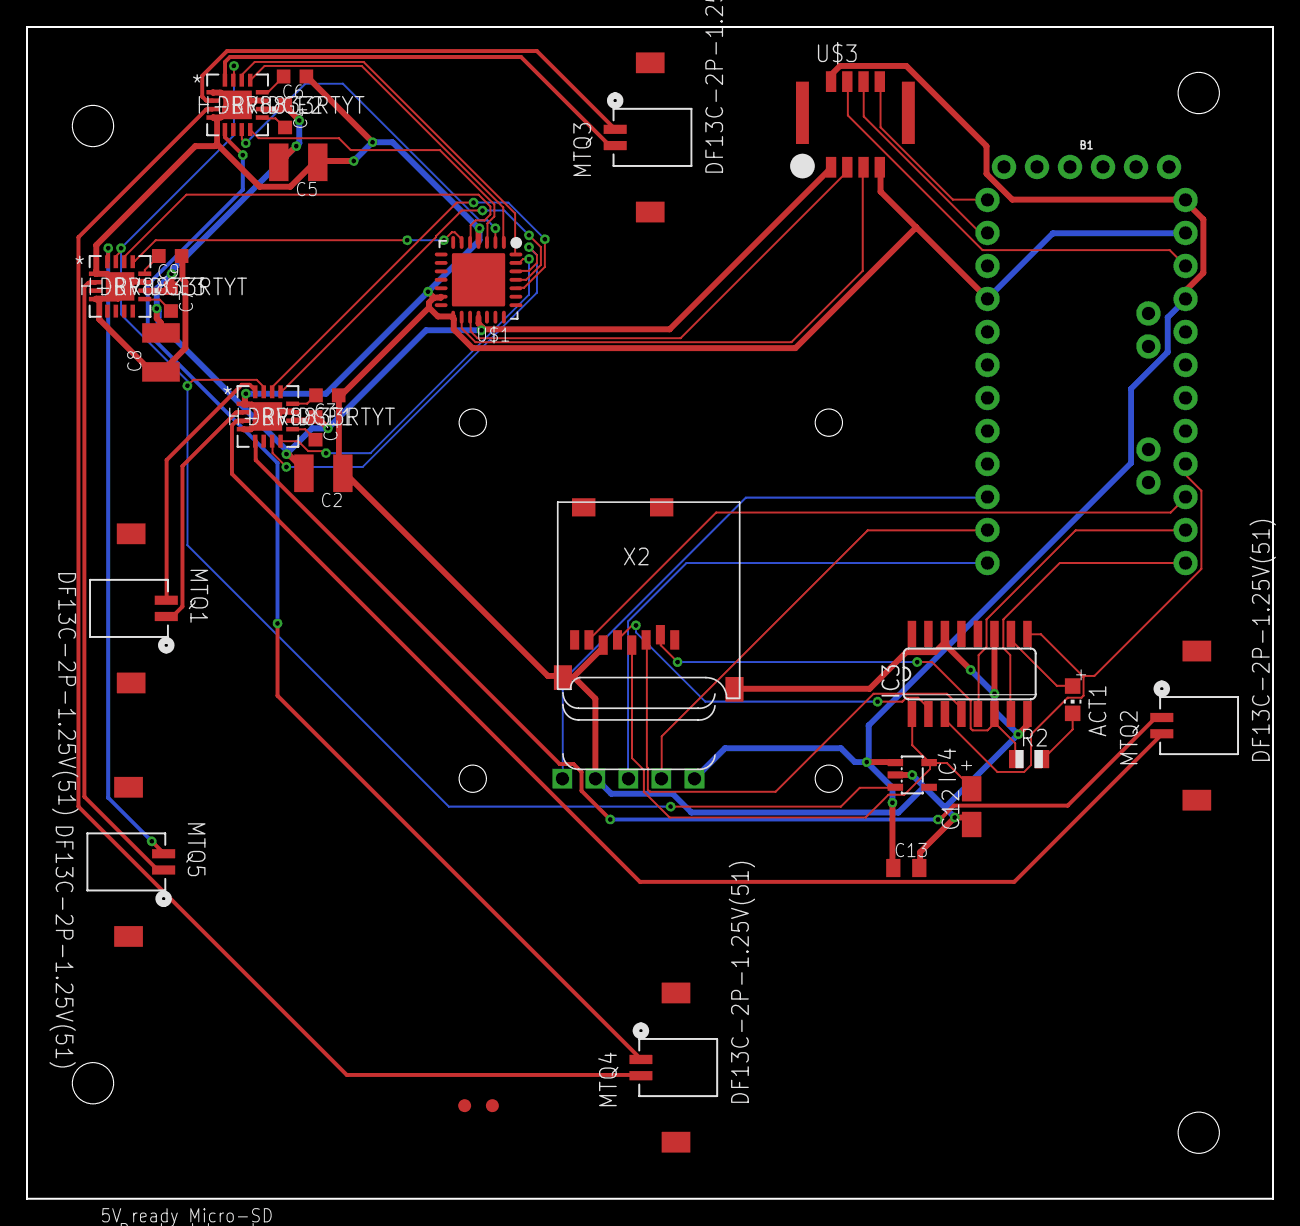
[picture p18: board control_boardv4.brd from above]

Board: 2 copper layers, 95.9 x 90.2 mm, 30 parts (0 on the bottom side), 48 nets.

Parts:
ACT1: RED; CHIP-LED0805
B1: ARDUINO_PRO_MINI
C1, C4, C7: 0.01uF; C0603K
C2, C5, C8: 10uF; C1210K
C3, C6, C9: 2.2uF; C0603K
C12: 10uF/10V; A/3216-18R
C13: 0.1uF; C0805K
H-BRIDGE1, H-BRIDGE2, H-BRIDGE3: DRV8833RTYT; RTY16
IC3: 4050D; SO16
IC4: LP298XS; SOT23-5L
MTQ1, MTQ2, MTQ3, MTQ4, MTQ5: DF13C-2P-1.25V(51); CON2_1X2_U_DF13
R2: 1K; R0805
U$1: PCA9685BS; HVQFN28
U$2: UCAM-III
U$3: MOLEX_MICRO_LOCK_PLUS_8
U$6, U$7: FIDUCIAL; FIDUCIAL_1MM
X2: MICROSD

Connections:
5V_1: C1.1, C2.2, C4.1, C5.2, C7.1, C8.2, H-BRIDGE1.10, H-BRIDGE2.10, H-BRIDGE3.10, U$1.25, U$3.8
5V_2: B1.21, B1.24, C13.1, IC4.1, U$2.1, U$3.1
+3V3: C12.+, IC3.1, IC4.5, X2.4
CLK: B1.16, IC3.3, IC3.9
CS: B1.13, IC3.7
DI: B1.14, IC3.5
DO: B1.15, X2.7
GND: B1.4, B1.23, C2.1, C3.1, C5.1, C6.1, C8.1, C9.1, C12.-, C13.2, H-BRIDGE1.1, H-BRIDGE1.4, H-BRIDGE1.11, H-BRIDGE1.17, H-BRIDGE2.1, H-BRIDGE2.4, H-BRIDGE2.11, H-BRIDGE2.17, H-BRIDGE3.1, H-BRIDGE3.4, H-BRIDGE3.11, H-BRIDGE3.17, IC3.8, IC3.11, IC3.14, IC4.2, U$1.11, U$1.20, U$1.22, U$2.4, U$3.5, X2.6, X2.MT1, X2.MT2
MTQ1_A: H-BRIDGE1.14, U$1.3
MTQ1_B: H-BRIDGE1.13, U$1.4
MTQ2_A: H-BRIDGE1.7, U$1.5
MTQ2_B: H-BRIDGE1.8, U$1.6
MTQ3_A: H-BRIDGE2.14, U$1.7
MTQ3_B: H-BRIDGE2.13, U$1.8
MTQ4_A: H-BRIDGE2.7, U$1.9
MTQ4_B: H-BRIDGE2.8, U$1.10
MTQ5_A: H-BRIDGE3.14, U$1.12
MTQ5_B: H-BRIDGE3.13, U$1.13
unnamed: H-BRIDGE2.16, MTQ3.2
unnamed: C3.2, H-BRIDGE1.12
unnamed: H-BRIDGE1.2, MTQ1.1
unnamed: H-BRIDGE1.16, MTQ1.2
unnamed: H-BRIDGE1.5, MTQ2.1
unnamed: H-BRIDGE1.3, MTQ2.2
unnamed: C1.2, H-BRIDGE1.9
unnamed: H-BRIDGE2.5, MTQ4.1
unnamed: H-BRIDGE2.3, MTQ4.2
unnamed: C6.2, H-BRIDGE2.12
unnamed: C4.2, H-BRIDGE2.9
unnamed: H-BRIDGE2.2, MTQ3.1
unnamed: H-BRIDGE3.16, MTQ5.2
unnamed: C9.2, H-BRIDGE3.12
unnamed: C7.2, H-BRIDGE3.9
unnamed: H-BRIDGE3.2, MTQ5.1
unnamed: ACT1.A, IC3.10
unnamed: IC3.2, X2.5
unnamed: IC3.6, R2.1, X2.2
unnamed: ACT1.C, R2.2
unnamed: IC3.4, X2.3
unnamed: B1.10, U$2.5
RST: B1.22, U$3.2
RX: B1.12, U$2.3
RXI: B1.2, U$3.3
SCL: U$1.23, U$3.6
SDA: U$1.24, U$3.7
TX: B1.11, U$2.2
TXO: B1.1, U$3.4
VCC: H-BRIDGE1.15, H-BRIDGE2.15, H-BRIDGE3.15, IC4.3
