AA-CubeSat-Team/soci_pcb/(commit log)

2020-09-15 Initial commit. Setup 4 initial project folders and created directory for libraries and design rules.
    [eps_flatsat_module.brd, eps_flatsat_module.sch, obc.brd, obc.sch, rtc.brd, rtc.sch, sensor.brd, sensor.sch]
2020-09-15 Updates to sensor board. Routed sensors
    [sensor.brd, sensor.sch]
2020-09-15 Updated sensor board. First revision of completely routed board
    [sensor.brd, sensor.sch]
2020-09-15 Added oshpark 2 layer design rule, updated gyroscope library, added new gyroscope footprint to sensor board
    [sensor.brd, sensor.sch]
2020-09-25 Converted sensor board to 4 layers. Re-routed magnetometers/gyros and ripped up most other traces
    [sensor.brd, sensor.sch]
2020-09-25 Completed first revision of 4 layer sensor board
    [sensor.brd, sensor.sch]
2020-11-11 RT1020 libraries added, OBC routed for RT1020
    [obc.brd, obc.sch]
2020-11-11 sensor board updated
    [sensor.brd, sensor.sch]
2021-09-18 new OBC files
    [obc.brd, obc.sch]
2021-09-24 Update sensor.brd
    Updated with fix to I2C lines
    [sensor.brd]
2021-09-24 Update sensor.sch
    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
    [sensor.sch]
2021-10-27 Add files via upload
    updated OBC with revisions and added a 20 pin jtag connector
    [OBC.brd, OBC.sch]
2021-11-12 Add files via upload
    updated CIA board eagle files:
    - Re routed imaging side of CIA board to troubleshoot/fix issues
    - Adjusted design language (wider traces, better spacing, etc)
    [CIA_Update.brd.sch, CIA_Update.brd_.brd]
2021-12-10 Add files via upload
    Eagle files for manufactured boards - MacroFab: November, 2021
    [CIA_manufactured.brd, CIA_manufactured.sch, COM_R_manufactured.brd, COM_R_manufactured.sch, OB1_sensor_manufactured.brd, OB1_sensor_manufactured.sch, OBC_manufactured.brd, OBC_manufactured.sch]
