AA-CubeSat-Team/soci_pcb/(notices)

Notices in the files:
parts and their libraries:
1985881: COPYRIGHT: Copyright (C) 2018 Accelerated Designs. All rights reserved
SparkFun-Boards: Licensing: Creative Commons ShareAlike 4.0 International - https://creativecommons.org/licenses/by-sa/4.0
